mrrb/tfg/USB_Sniffer_ESP32/reference.rst

**Reference**
=============

In this files I'll anotate all the references used to develop the current project.

* *ESP32-idf template.* `ESP32-IDF-template.`_
* *ESP-IDF Docs.* `ESP-IDF Docs.`_

.. _ESP32-IDF-template.: https://github.com/espressif/esp-idf-template
.. _ESP-IDF Docs.: http://esp-idf.readthedocs.io/
