mrrb/tfg/docs/urls.md

# Lista de URLs con información relevante.

### FPGA - Verilog

1. [Tutorial de FPGA en Verilog - Juan Gonzalez-Gomez aka Obijuan](https://github.com/Obijuan/open-fpga-verilog-tutorial/wiki)

2. [ICE40 Family Datasheet - Lattice Semiconductor](http://www.latticesemi.com/view_document?document_id=49312)

3. [Project IceStorm - Clifford Wolf & Mathias Lasser](http://www.clifford.at/icestorm/)

4. [Verilog HDL Quick Reference Guide - Stuart Sutherland](http://sutherland-hdl.com/pdfs/verilog_2001_ref_guide.pdf)

5. [Lattice primitivas - Lattice Semiconductor](http://www.latticesemi.com/~/media/LatticeSemi/Documents/TechnicalBriefs/SBTICETechnologyLibrary201504.pdf)

### Protocolo USB

1. [USB made simple - MQP Electronics Ltd](http://www.usbmadesimple.co.uk/)

### Raspberry PI

1. [introducción a la programación con Raspberry Pi - Francisco Moya](https://franciscomoya.gitbooks.io/taller-de-raspberry-pi/content/es/index.html)
