mrrb/tfg/docs/proyecto/memoria/tex/simbolos.tex

\chapter*{Lista de acrónimos, siglas y símbolos}
\label{LDS}

\begin{longtable}{lcp{.8\textwidth} }

\multicolumn{3}{l}{\textbf{Acrónimos}}\\
\\
$bit$ & --- & Acrónimo inglés de \textit{binary digit} (dígito binario en español). Es la unidad más básica de información en informática, electrónica y telecomunicaciones.\\

PID & --- & Para una trama usb, acrónimo inglés de \textit{Packet ID} (identificador de paquete en español). \\

\\
\\

\multicolumn{3}{l}{\textbf{Siglas}}\\
\\
API & --- & Siglas inglesas de \textit{Application Programming Interface} (Interfaz de Programación de Aplicaciones en español).\\

CSV & --- & Siglas inglesas de \textit{Comma Separated Values} (Valores Separados por Comas en español).\\

FIFO & --- & Siglas inglesas de \textit{Firts-In Firts-Out} (Primero-en-Entrar Primero-en-Salir en español).\\

FPGA & --- & Siglas inglesas de \textit{Field-Programmable Gate Array} (Matriz de Puertas Programables en español).\\

HID & --- & Siglas inglesas de \textit{Human Interface Device} (Dispositivo de Interfaz Humana en español).\\

LED & --- & Siglas inglesas de \textit{Light Emitting Diode} (Diodo Emisor de Luz en español).\\

PC & --- & Siglas inglesas de \textit{Personal Computer} (Computadora Personal en español).\\

PCB & --- & Siglas inglesas de \textit{Printed Circuit Board} (Placa de Circuito Impreso en español).\\

RAM & --- & Siglas inglesas de \textit{Random Access Memory} (Memoria de Acceso Aleatorio en español).\\

ULPI & --- & Siglas inglesas de \textit{UTMI+ Low Pin Interface} (Interfaz UTMI+ de Bajos Pines en español).\\

USB & --- & Siglas inglesas de \textit{Universal Serial Bus} (Bus Universal en Serie en español).\\

\\
\\

\multicolumn{3}{l}{\textbf{Símbolos}}\\
\\
$B$ & --- & \emph{Byte}. Unidad de información, que por lo general agrupa 8 $bits$.\\

$Bd$ & --- & Baudio. Unidad que indica la cantidad de símbolos enviados por segundo en transmisiones digitales.\\

$Hz$ & --- & Hercio. Unidad del Sistema Internacional que indica la frecuencia de oscilación de una partícula en un periodo de un segundo.\\

$V$ & --- & Voltio. Unidad del Sistema Internacional que indica la tensión eléctrica.\\

\\
\\

\end{longtable}
