mrrb/tfg/docs/proyecto/memoria/tex/simulacion_final.tex

\chapter{Resultado de la simulación final}
\label{ch:simulacion-final}

\begin{figure}[htbp]
    \centering
    \hspace*{-1cm}
    \caption{Simulación final de botones externos (1 y 2) y lectura de registro (3)}
    \label{fig:simulacion_1_2_3}
\end{figure}

\begin{figure}[htbp]
    \centering
    \hspace*{-1.25cm}
    \caption{Simulación final de transmisión de registro (4), escritura de registro (5) y captación USB (6)}
    \label{fig:simulacion_4_5_6}
\end{figure}

\begin{figure}[htbp]
    \centering
    \hspace*{-0.9cm}
    \caption{Simulación final de envío de captura al PC (7)}
    \label{fig:simulacion_7}
\end{figure}

\begin{figure}[htbp]
    \centering
    \hspace*{-1.1cm}
    \caption{Simulación final de captación USB (8), cambio de estado del bus (9) y desactivación de envío (10)}
    \label{fig:simulacion_8_9_10}
\end{figure}
