mrrb/tfg/docs/proyecto/memoria/tex/diagramas_FPGA.tex

\chapter{Diagramas internos de la \emph{FPGA}}
\label{ch:diagramas}

%* Diagrama TOP
\begin{figure}[p]
    \centering
    
    \caption{Esquema principal usado en la \emph{FPGA}.}
    \label{fig:diagrama_fgpa_top}
\end{figure}

%* Diagrama UART_main
\begin{figure}[p]
    \centering
    
    \caption{Esquema principal del módulo de comunicación serie.}
    \label{fig:diagrama_fgpa_uart_main}
\end{figure}

%* Diagrama UART_Tx
\begin{figure}[p]
    \centering
    
    \caption{Esquema del submódulo de transmisión serie.}
    \label{fig:diagrama_fgpa_uart_tx}
\end{figure}

%* Diagrama UART_Rx
\begin{figure}[p]
    \centering
    
    \caption{Esquema del submódulo de recepción serie.}
    \label{fig:diagrama_fgpa_uart_rx}
\end{figure}

%* Diagrama ULPI_main
\begin{figure}[p]
    \centering
    
    \caption{Esquema principal del módulo de comunicación \emph{ULPI}.}
    \label{fig:diagrama_fgpa_ulpi_main}
\end{figure}

%* Diagrama ULPI_reg_rrite
\begin{figure}[p]
    \centering
    
    \caption{Esquema del submódulo de escritura de registros \emph{ULPI}.}
    \label{fig:diagrama_fgpa_ulpi_reg_write}
\end{figure}

%* Diagrama ULPI_reg_read
\begin{figure}[p]
    \centering
    
    \caption{Esquema del submódulo de lectura de registros \emph{ULPI}.}
    \label{fig:diagrama_fgpa_ulpi_reg_read}
\end{figure}

%* Diagrama ULPI_recv
\begin{figure}[p]
    \centering
    
    \caption{Esquema del submódulo de recpción de datos \emph{USB} a través de \emph{ULPI}.}
    \label{fig:diagrama_fgpa_ulpi_recv}
\end{figure}

%* Diagrama OP_buffer
\begin{figure}[p]
    \centering
    
    \caption{Esquema del módulo de almacenaje de las operaciones pendientes.}
    \label{fig:diagrama_fgpa_op}
\end{figure}
