mrrb/tfg/docs/proyecto/memoria/tex/diagramas_flujo/UART_Rx.tex

\begin{tikzpicture}[auto]
    % Config
    \tikzFlow

    % Place nodes
    \node [flowStart] (idle) {Reposo};
    
    \node [flowDecision] at ($ (idle)+(0,-2.65) $) (rxLow) {Entrada del puerto serie a nivel bajo?};
    
    \node [flowBase, below of=rxLow] (init) {Reinicio del contador de $bits$};
    
    \node [flowBase] at ($ (rxLow.east)+(3.85,1) $) (read) {Se guarda $bit$ entrante en el registro de desplazamiento};

    \node [flowDecision, below of=read] (10bitsDone) {Se han leído los $10~bits$ del mensaje?};
    
    \node [flowBase] at ($ (read)+(4.1,0) $) (increase) {Incremento del contador de $bits$};

    \node [flowBase] at ($ (10bitsDone)+(4.1,0) $) (wait) {Se espera un pulso del reloj de baudios};

    \node [flowBase, below of=10bitsDone] (save) {Se almacena el byte en memoria};

    % % Draw edges
    \path [flowLine] (idle) -- (rxLow);
    \path [flowLine] (rxLow) -- (init);
    \path [flowLine] (init.south) |- +(3.5,-1) |- (read.west);
    \path [flowLine] (read) -- (10bitsDone);
    \path [flowLine] (increase) -- (read);
    
    \node [flowHide] at ($ (idle)+(2.75,0) $) (anchor1) {};
    \path [flowLine] (rxLow) -- node [right, xshift=-1.2cm] {Sí} (init);
    \path [flowLine] (rxLow.east) node [above, xshift=0.2cm] {No} -| (anchor1.center);
    
    \path [flowLine] (save.east) -| +(4.5,0) |- (idle.east);
    
    \path [flowLine] (wait) -- (increase);
    \path [flowLine] (10bitsDone.east) node [above, xshift=0.2cm] {No} -- (wait);
    \path [flowLine] (10bitsDone) -- node [right, xshift=-1.2cm] {Sí} (save);
\end{tikzpicture}

% \begin{tikzpicture}[auto]
%     % Config
%     \tikzFlow

%     % Place nodes
%     \node [flowStart] (idle) {Reposo};
    
%     \node [flowDecision, below of=idle] (rxLow) {Entrada del puerto serie a nivel bajo?};
    
%     \node [flowBase, below of=rxLow] (init) {Reinicio del contador de $bits$};
    
%     \node [flowBase, below of=init] (read) {Se guarda $bit$ entrante en el registro de desplazamiento};

%     \node [flowDecision, below of=read] (10bitsDone) {Se han leído los $10~bits$ del mensaje?};
    
%     \node [flowBase] at ($ (read)+(4.1,0) $) (increase) {Incremento del contador de $bits$};

%     \node [flowBase] at ($ (10bitsDone)+(4.1,0) $) (wait) {Se espera un pulso del reloj de baudios};

%     \node [flowBase, below of=10bitsDone] (save) {Se almacena el byte en memoria};

%     % % Draw edges
%     \path [flowLine] (idle) -- (rxLow);
%     \path [flowLine] (rxLow) -- (init);
%     \path [flowLine] (init) -- (read);
%     \path [flowLine] (read) -- (10bitsDone);
%     \path [flowLine] (increase) -- (read);
    
%     \node [flowHide] at ($ (idle)+(3.5,0) $) (anchor1) {};
%     \path [flowLine] (rxLow) -- node [right, xshift=-1.2cm] {Sí} (init);
%     \path [flowLine] (rxLow.east) -| node [above, xshift=-1.2cm] {No} (anchor1.center);
    
%     \path [flowLine] (save.east) -| +(4.5,0) |- (idle.east);
    
%     \path [flowLine] (wait) -- (increase);
%     \path [flowLine] (10bitsDone.east) node [above, xshift=0.2cm] {No} -- (wait);
%     \path [flowLine] (10bitsDone) -- node [right, xshift=-1.2cm] {Sí} (save);
% \end{tikzpicture}
