mrrb/tfg/docs/anteproyecto/README.md

# Anteproyecto
Documento previo en el que se plantean posibles pautas y medios, así como información util y elementos de referencia a usar para el satisfacotiro desarrollo del TFG.
