mrrb/tfg/docs/files.md

# Información sobre los archivos de este directorio.

### iCE40LPHXFamilyDataSheet.pdf

Hoja de características de la familia de FPGA's ICE40 LP/HX de Lattice.

### icestick_pinout.png

Pinout del ICEstick - BQ

### SBTICETechnologyLibrary201504.pdf

Documento con primitivas para la FPGA
