mrrb/tfg/docs/proyecto/memoria/contenido.tex

%! => Hay que hacerlo, no hay nada hecho, o faltan partes
%! Revisar => Hay que terminarlo o hay que revisar que este bien redactado
%* Comprobar => Hay que asegurarse que este correctamente redactado (sobretodo en cuanto a ortografía)
%* Listo => Totalmente redactado, falta comprobación final cuando este todo el proyecto finalizado
%* Perfecto => Nada más que hacer

% Licencia
%\license{Todos los derechos reservados.}

% Símbolos (omitir si no hay gran cantidad de ellos)
\listofsymbols{simbolos.tex} %* Perfecto
\portada

\input{agradecimientos.tex} %* Perfecto
% \input{dedicatoria.tex}
\input{resumen.tex}         %* Perfecto
% \input{resumen_short.tex}

\indices

% Distribución del documento
% Documento científico-técnico (anexo TFG-08b)
\input{introduccion.tex}   %* Perfecto
\input{antecedentes.tex}   %* Perfecto
\input{objetivos.tex}      %* Perfecto
\input{contribuciones.tex} %* Perfecto
\input{procedimiento.tex}  %* Perfecto
\input{resultados_hw.tex}  %* Perfecto
\input{resultados_sw.tex}  %* Perfecto
\input{conclusiones.tex}   %* Perfecto
