mrrb/tfg/docs/proyecto/memoria/datos-tfg.tex

% Datos del TFG
\title{Analizador USB}
\author{Mario Rubio Asensio}
\email{mario.rubio2@alu.uclm.es}
\director{Francisco Moya Fernández}
\tfgid{19-B-225530}
\gitrepo{https://github.com/mario-mra/tfg}

% Opcionales
% \homepage{https://github.com/FranciscoMoya/eii-tfg}
% \address{UCLM --- Escuela de Ingeniería Industrial\\
% Campus Universitario de la Real Fábrica de Armas}
% \zipcode{45071}
% \phone{925 268 800 x.3729}
