mrrb/tfg/docs/proyecto/memoria/tex/agradecimientos.tex

\begin{agradecimientos}

    \itshape

    En primer lugar, quisiera agradecer al director del presente Trabajo Fin de Grado, D. Francisco Moya Fernández, por brindarme la oportunidad de realizar este proyecto  y por la ayuda ofrecida.
    
    A mis padres y hermana, que siempre han estado y estarán para apoyarme en todo momento.

    A mis compañeros de la carrera, con los que tantos momentos he compartido.

    A mis amigos, tanto de León como de Toledo, que nunca fallan.

    A todos ellos, muchas gracias.
 
\end{agradecimientos}
