mrrb/tfg/docs/proyecto/memoria/tex/introduccion.tex

\chapter{Introducción} 
\label{ch:introduccion}

%* Listo
Durante estas dos ultimas décadas, el bus USB\cite{craigpeacock2010} (\emph{Universal Serial Bus}) se ha impuesto como uno de los grandes pilares de la comunicación en la informática moderna, no solo en productos de grandes masas (como dispositivos de almacenamiento o periféricos HID\cite{usb:hid}), sino también en sectores más complejos y robustos como lo son el militar o el industrial.

%* Listo
Al ser un bus tan ampliamente utilizado, existen multitud de ocasiones en las que sería de gran utilidad poder disponer de los datos que circulan por él, ya sea para fines de seguridad\cite{NISSIM2017675}, control, ingeniería inversa o búsqueda y solución de problemas. Por ello, es de gran interés disponer de sistemas capaces de realizar dicha tarea de forma económica y sencilla.

%* Listo
Se considera entonces la elaboración del presente proyecto, en el que se plantea un sistema de \textbf{captación de tramas USB por \textit{hardware}} que sea capaz como mínimo de obtener señales tanto \textit{Low Speed} ($1.5~Mbit/s$) como \textit{Full Speed} ($12~Mbit/s$), todo ello a un coste bajo que pueda suplir la demanda existente, y utilizando en gran medida herramientas y utilidades de código libre.

%* Listo
\section{Organización de la memoria} 
La organización de este documento es conforme al anexo TFG-08b\cite{tfg08b} de la Normativa Trabajo Fin de Grado de la Escuela de Ingeniería Industrial de Toledo, de la Universidad de Castilla-La Mancha, aprobada en Junta de Escuela el 23 de junio de 2016. Se descompone en los siguientes capítulos.

%* Listo
\begin{description}
    %* Listo
    \item[Capítulo~\ref{ch:introduccion}]
    Presente capítulo. Se introduce el problema a tratar.
    
    %* Listo
    \item[Capítulo~\ref{ch:antecedentes}]
    Analiza los antecedentes y el estado del arte de los dispositivos de captura USB.
    
    %* Listo
    \item[Capítulo~\ref{ch:objetivos}]
    Enumera y justifica los objetivos del proyecto.
    
    %* Listo
    \item[Capítulo~\ref{ch:contribuciones}]
    Enumera las principales contribuciones y aportaciones en este TFG.
    
    %* Listo
    \item[Capítulo~\ref{ch:procedimiento}]
    Describe las directivas de desarrollo empleadas durante la ejecución del TFG.
    
    %* Listo
    \item[Capítulo~\ref{ch:resultados_hw}]
    Describe en detalle las pruebas realizadas y los resultados obtenidos de los elementos \emph{hardware} del sistema.
    
    %* Listo
    \item[Capítulo~\ref{ch:resultados_sw}]
    Describe en detalle los resultados obtenidos de los elementos \emph{software} del sistema.
    
    %* Listo
    \item[Capítulo~\ref{ch:conclusiones}]
    Recopila las principales conclusiones del proyecto y posibles trabajos futuros.
    
    %* Listo
    \item[Anexo~\ref{ch:diagramas}]
    Muestra gráficamente las relaciones entre los módulos diseñados.
    
    %* Listo
    \item[Anexo~\ref{ch:maquinas-estados}]
    Muestra los esquemas de las maquinas de estados internas de los módulos diseñados.
    
    %* Listo
    \item[Anexo~\ref{ch:simulacion-final}]
    Muestra el resultado de la simulación final del sistema.
    
    %* Listo
    \item[Anexo~\ref{ch:manual}]
    Detalla los procedimientos a seguir para la instalación y utilización del sistema.
\end{description}

%* Listo
\section{Repositorio de información}
Todo el material generado durante la ejecución de este proyecto está disponible tanto en el disco adjunto, como en \thegitrepo{}. Se incluye el código \LaTeX{} del presente documento, el código fuente de los programas y módulos realizados, y todos los datos generados en la evaluación de resultados.

% \chapter{Introducción} 
% \label{ch:introduccion-plantilla}

% En este capítulo debes introducir el problema sin divagar, sin copiar de otros documentos y sin utilizar un lenguaje excesivamente técnico.  Tampoco utilices un lenguaje informal.  Este capítulo debería convencer al cliente de que el proyecto merece la pena.  Es decir, es un problema real y no está resuelto completamente.

% Redacta la introducción al final del TFG, cuando tengas elaborado el capítulo de antecedentes, los resultados y su discusión.  De esta forma podrás evitar repetir argumentos que ya están en esos capítulos.  La introducción debe introducir también el contexto en el que se desarrolla el TFG.

% Utiliza secciones y subsecciones para organizar el contenido del capítulo.  Utiliza preferentemente frases cortas.

% Por cierto, el cliente es el que paga.  En el TFG el que paga es el tribunal y tu director o directores.  Así que a quien tienes que convencer es a ellos.  El tribunal no lo conocerás a priori.  Por eso la memoria debe estar escrita para que la entienda alguien que no es especialista en el campo de aplicación.  Pero eso no implica que se toleren la falta de rigor o la falta de argumentación técnica.  Solo implica que los argumentos específicos hay que explicarlos o citar la fuente que los explica.

% \section{Organización de la memoria} 
% \label{sec:organizacion-memoria}

% La organización de este documento es conforme al anexo TFG-08b~\cite{tfg08b} de la Normativa Trabajo Fin de Grado de la Escuela de Ingeniería Industrial de Toledo, de la Universidad de Castilla-La Mancha, aprobada en Junta de Escuela el 23 de junio de 2016. Se descompone en los siguientes capítulos.

% \begin{description}
%     \item[Capítulo~\ref{ch:antecedentes}] Analiza los antecedentes y estado del arte en relación al tema del proyecto.
%     \item[Capítulo~\ref{ch:objetivos}] Enumera y justifica los objetivos del proyecto y establece los límites intrínsecos y extrínsecos de ejecución del TFG.
%     \item[Capítulo~\ref{ch:contribuciones}] Enumera las principales contribuciones y aportaciones personales del autor en este TFG.
%     \item[Capítulo~\ref{ch:procedimiento}] Describe la metodología de desarrollo empleada durante la ejecución del TFG.
%     \item[Capítulo~\ref{ch:resultados}] Describe en detalle las pruebas realizadas y los resultados obtenidos.
%     \item[Capítulo~\ref{ch:discusion-resultados}] Discute los resultados en relación a los objetivos del proyecto.
%     \item[Capítulo~\ref{ch:conclusiones}] Recopila las principales conclusiones del proyecto.
%     \item[Anexos] Complementan la información del cuerpo del documento con información técnica útil para reproducir los resultados, pero innecesaria para comprender en su totalidad el TFG realizado.
% \end{description}

% \warning{Al finalizar el resto de los capítulos revisa esta descripción del documento para que coincida con lo que realmente contiene la memoria.  Por ejemplo, es frecuente fusionar varios capítulos en uno cuando son muy pequeños.  También es frecuente lo contrario, dividir un capítulo en varios cuando es muy extenso.}

% \section{Repositorio de información}
% \label{sec:repositorio}

% Todo el material generado durante la ejecución de este proyecto está disponible en \thegitrepo{}.  El repositorio incluye el código \LaTeX{} del presente documento, el código fuente de los programas realizados o modificados, y todos los datos generados en la evaluación de resultados.
