mrrb/tfg/ICEstick/USB3300_sniffer/modules/SPI_COMM/SPI-paper.pdf

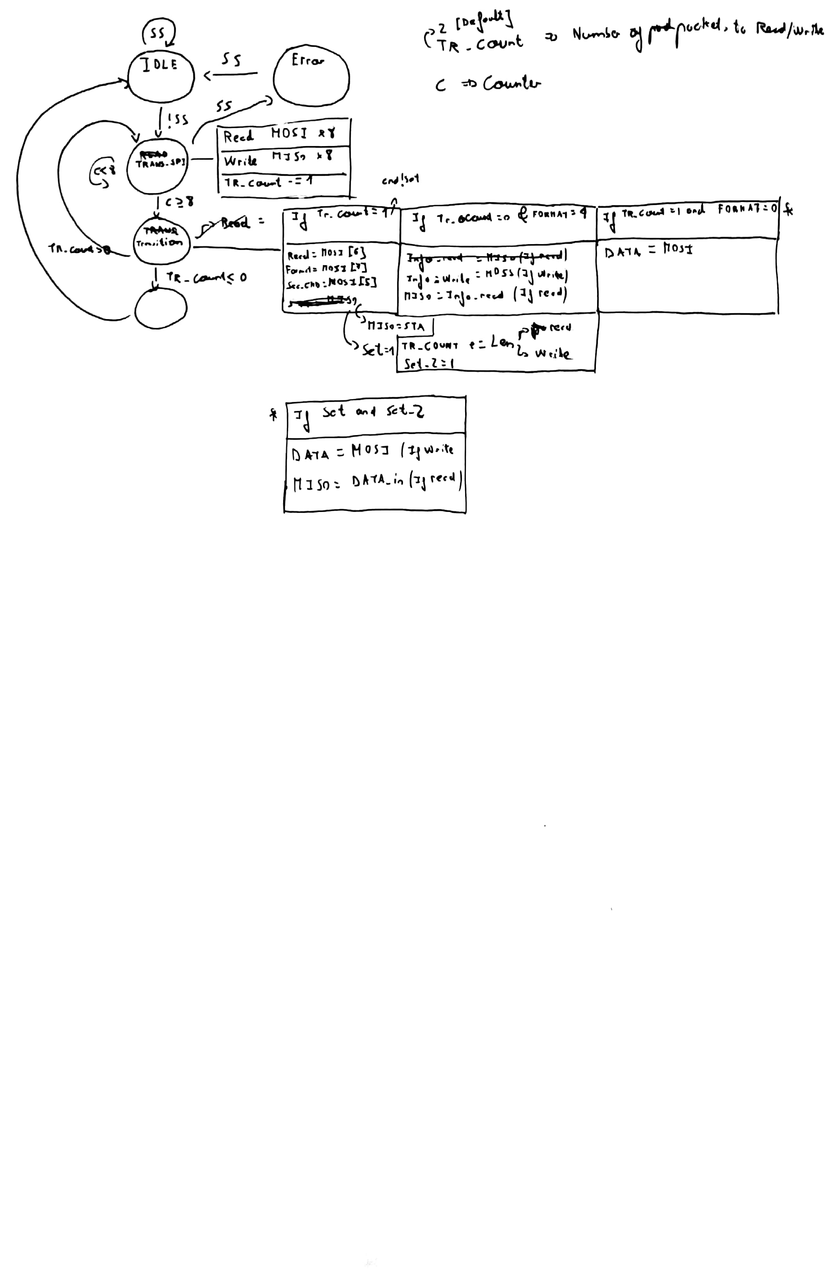
[picture p11: page 1]

Scanned by CamScanner

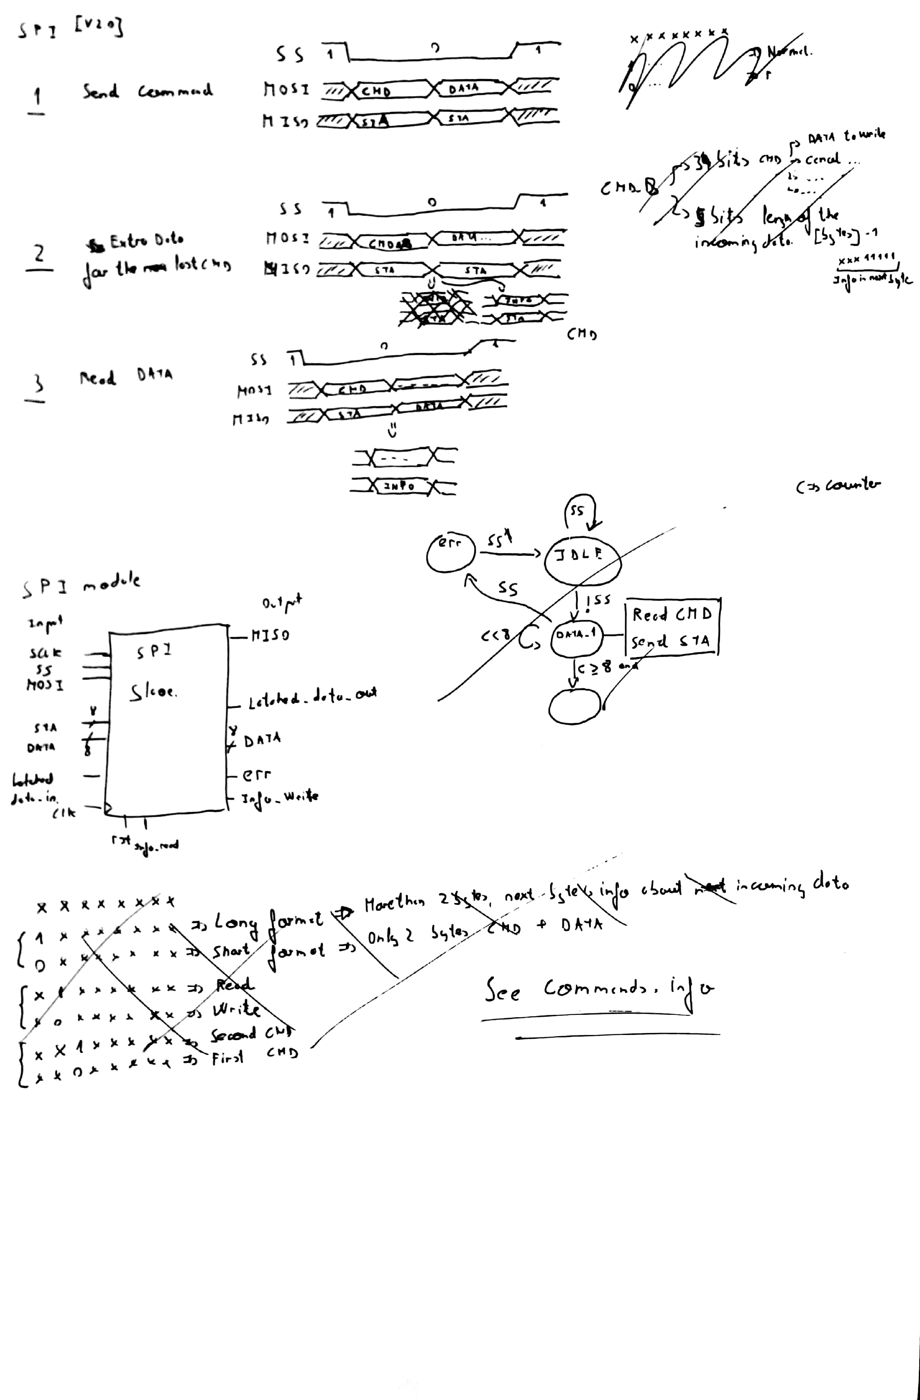
[picture p12: page 2]

Scanned by CamScanner
