mrrb/tfg/docs/proyecto/memoria/fig/esquemas/debounce-eps-converted-to.pdf

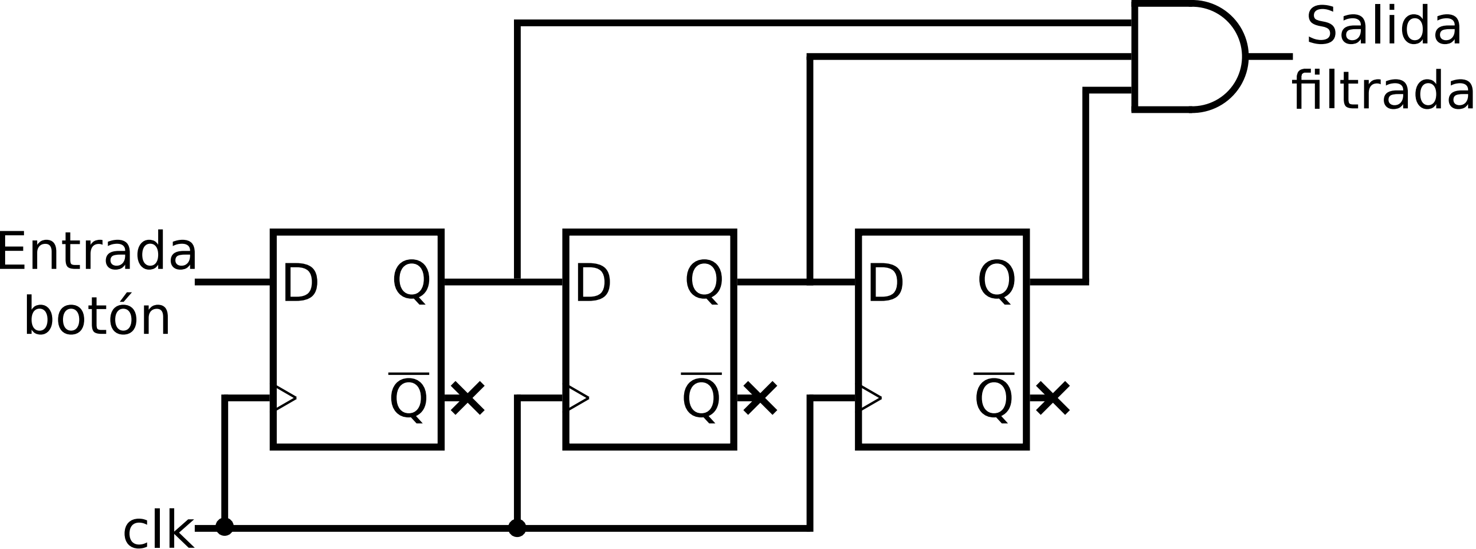
[picture p15: figure]
Salida ltrada; Entrada botón; clk
