mrrb/tfg/docs/proyecto/memoria/fig/esquemas/divisor_flipflop_D-eps-converted-to.pdf

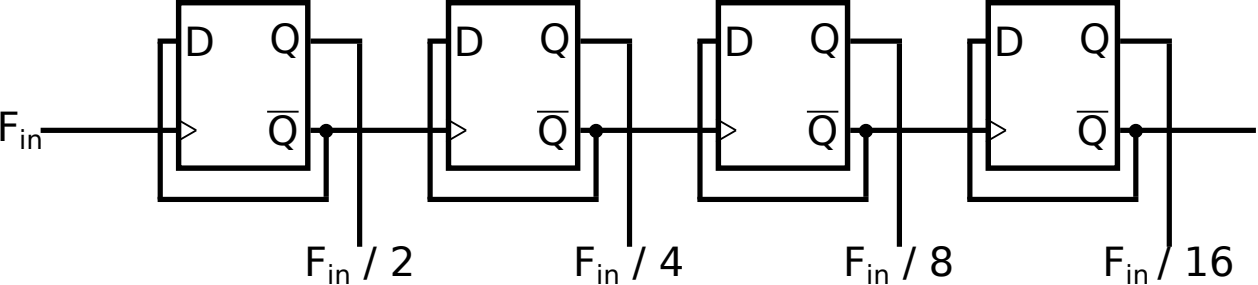
[picture p16: figure]
Fin / 2; Fin / 4; Fin / 8; Fin / 16; Fin
