mrrb/tfg/docs/proyecto/memoria/fig/esquemas/serie-eps-converted-to.pdf

# START B0B1B2B3B4B5B6B7 END

1

0

## Reloj

Bit de inicio (0) | Datos | Bit de parada (1)
