mrrb/tfg/docs/proyecto/memoria/fig/esquemas/FIFO-eps-converted-to.pdf

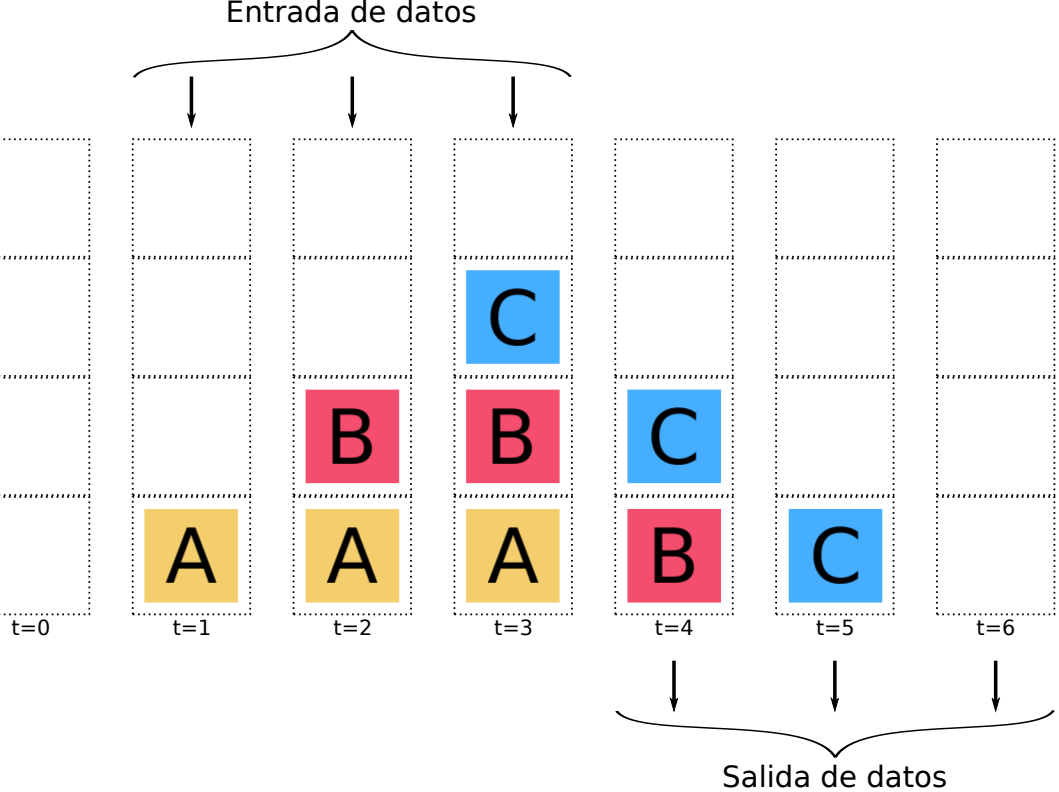
[picture p17: figure]
Entrada de datos; Salida de datos
