mrrb/tfg/docs/proyecto/memoria/tex/old/simbolos.tex

\chapter*{Lista de símbolos, abreviaciones y siglas}\label{LDS}

\begin{longtable}{lcp{.8\textwidth} }
\multicolumn{3}{l}{\textbf{Siglas}}\\
\\
PCB & --- & Siglas inglesas de \textit{Printed Circuit Board} (Placa de Circuito Impreso en español).\\
$V$ & --- & Volumen (m$^3$).\\
\\
\\
\multicolumn{3}{l}{\textbf{Minúsculas}}\\
\\
$c$ & --- & Velocidad de la luz en el vacío (m/s). La velocidad de la radiación electromagnética es independiente de la velocidad del emisor.\\
$i$ & --- & Raíz de menos uno (-).\\
\\
\\
\multicolumn{3}{l}{\textbf{Letras griegas}}\\
\\
$\alpha$ & --- & El principio de todo (-).\\
$\pi$ & --- & Pastel en inglés (-).\\
\end{longtable}

% Bauds
% bits
% Kbits
% HUB
% API
