mrrb/tfg/docs/proyecto/memoria/tex/old/agradecimientos.tex

\begin{agradecimientos}

%!
En primer lugar, quisiera agradecer al director del presente Trabajo Fin de Grado, Francisco Moya Fernández, ...

%!
También quisiera agradecer a todos lod profesores de la Escuela de Ingeniería Industrial de Toledo, ...

%!
A mis compañeros de carrera ...

%!
A mis amigos que ...

%!
A mis padres y hermana, que siempre han estado y estarán para apoyarme en todo momento ...

%? muletilla
que tanto me han soportado 

\end{agradecimientos}
