mrrb/tfg/docs/proyecto/memoria/tex/old/resumen.tex

\begin{resumen}
Aquí va el resumen en español. Entre 1000 y 1500 palabras (ver Anexo TFG-08). 

\warning{Escribe el resumen en estilo periodístico, desde lo más general a lo más específico.  Desde lo más importante a lo menos importante.  Esto último será especialmente útil cuando tengas que rellenar los \emph{Datos del TFG} en Campus Virtual. En el formulario solo te permiten añadir un máximo de 600 palabras.  Si el resumen está en formato periodístico bastará con seleccionar los primeros párrafos.}
\end{resumen}

\begin{abstract}
Write here the abstract in english. It must be between 1000 and 1500 words long (see Anexo TFG-08).
\end{abstract}
