mrrb/tfg/docs/proyecto/memoria/fig/capturas_terminal/utilidad_divisiones_reloj_raw.png

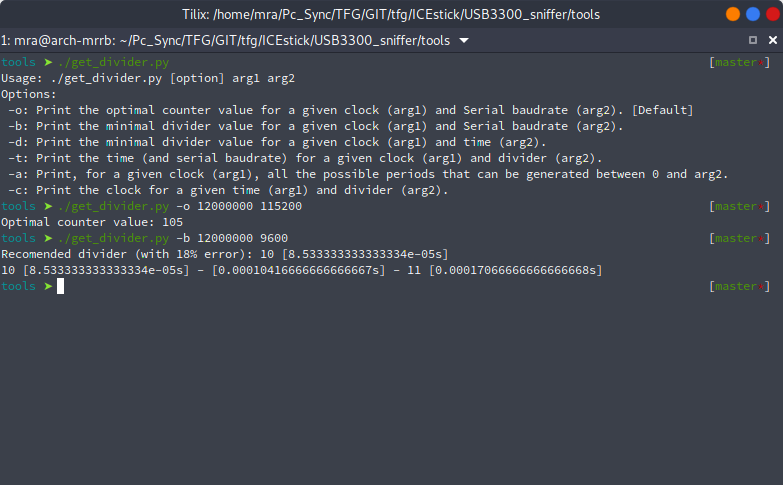
docs/proyecto/memoria/fig/capturas_terminal/utilidad_divisiones_reloj_raw.png
