mrrb/tfg/docs/proyecto/memoria/fig/diagramas_FPGA/diagramas_funcionamiento/diagramas_funcionamiento.png

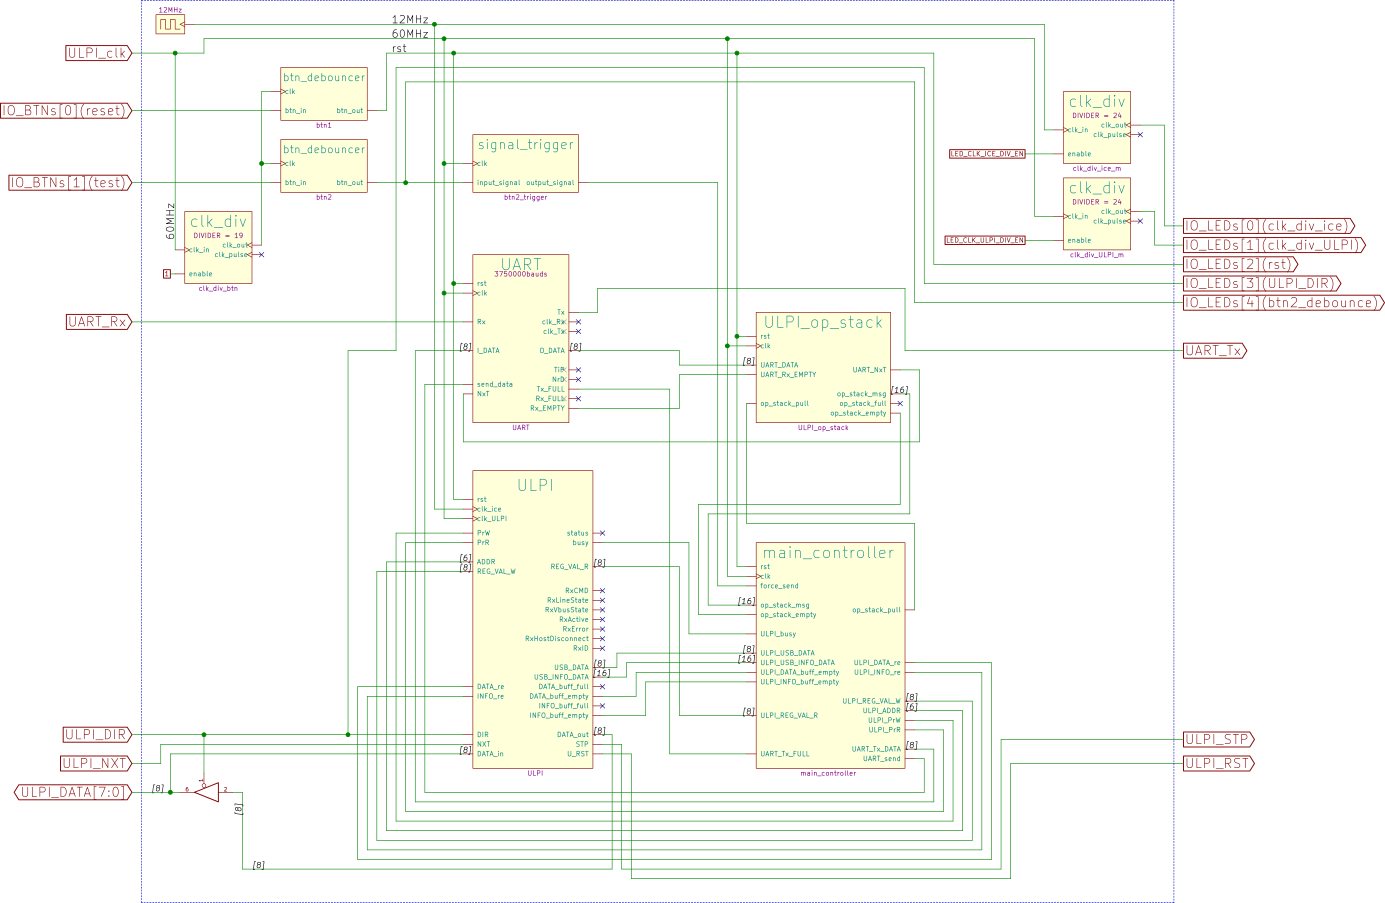
docs/proyecto/memoria/fig/diagramas_FPGA/diagramas_funcionamiento/diagramas_funcionamiento.png
