mrrb/tfg/docs/proyecto/memoria/fig/menu_app/escritura.png

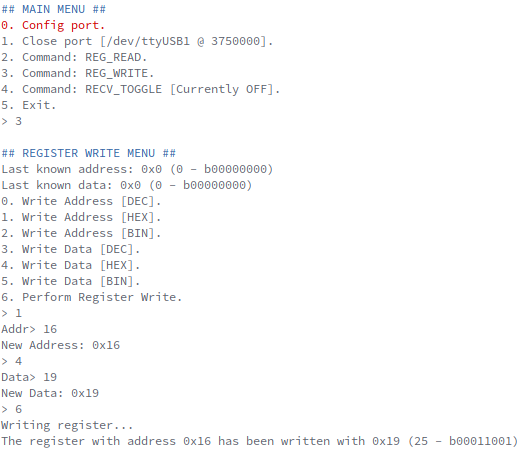
docs/proyecto/memoria/fig/menu_app/escritura.png
