mrrb/tfg/docs/proyecto/memoria/fig/menu_app/lectura.png

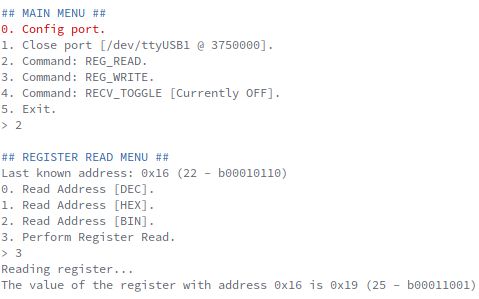
docs/proyecto/memoria/fig/menu_app/lectura.png
