mrrb/tfg/docs/proyecto/memoria/sty/uclm_to.jpg

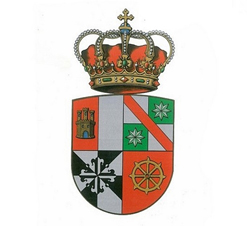
docs/proyecto/memoria/sty/uclm_to.jpg
