mrrb/tfg/docs/referencia/ESP32/ESP-32-Dev-Board-Pinout.jpg

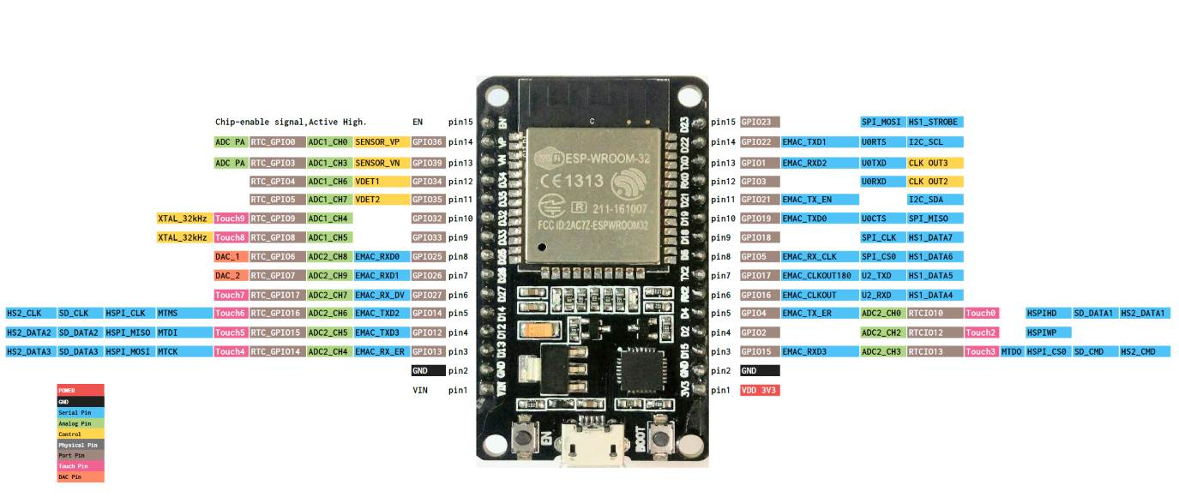
docs/referencia/ESP32/ESP-32-Dev-Board-Pinout.jpg
