mrrb/tfg/3D_base/P1_V1.stl

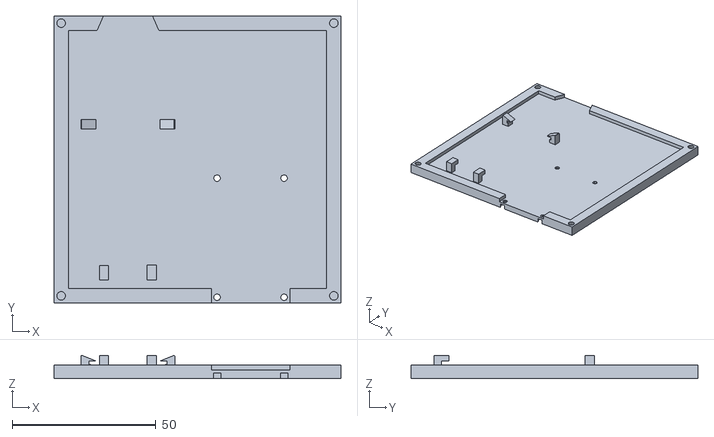
[picture p26: CAD file, 2018-11-26]
3D_base/P1_V1.stl
100.0 x 100.0 x 8.10
