mrrb/tfg/3D_base/test.stl

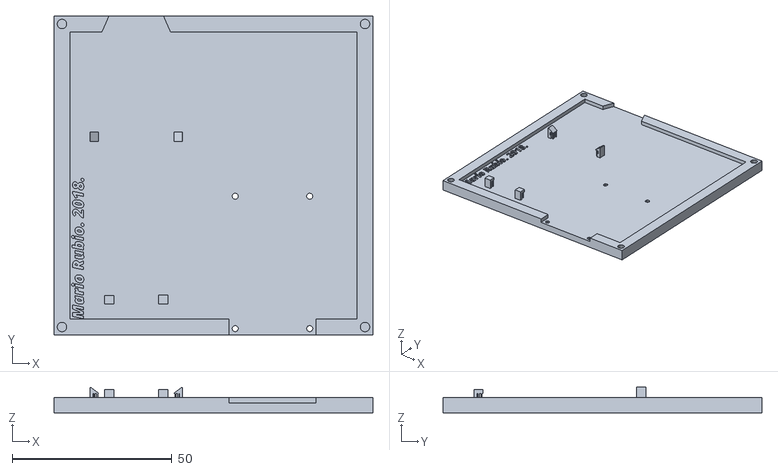
[picture p27: CAD file, 2018-11-26]
3D_base/test.stl
100.0 x 100.0 x 8.00
