mrrb/tfg/ICEstick/test/SPI_test/Readme.md

# Code obtain from

[julian1 - ice40-spi-usb-controller](https://github.com/julian1/ice40-spi-usb-controller)
