mrrb/tfg/docs/proyecto/memoria/tex/resultados_sw.tex

\chapter{Resultados \emph{software}}
\label{ch:resultados_sw}

%* Listo
Aun teniendo más importancia la parte \emph{hardware} comentada en el capítulo~\ref{ch:resultados_hw}, el sistema no sería funcional sin el \emph{software}, que utilizando los recursos creados, pueda recibir y almacenar la captura. Además, se han creado varias utilidades que han sido ayuda en las fases de diseño \emph{hardware}.

%* Listo
\section{Aplicaciones de apoyo}
A medida que se ha ido desarrollando la parte \emph{hardware}, se han creado varias utilidades en lenguaje \emph{Python}, con las que realizar cálculos de forma rápida o con las que comprobar el funcionamiento de ciertas partes del sistema. Dichas aplicaciones se encuentran en el directorio \emph{.\textbackslash ICEstick\textbackslash USB3300\_sniffer\textbackslash tools\textbackslash} del repositorio.

Hay que destacar las siguientes:
\begin{enumerate}
    %* Listo
    \item \textbf{Utilidad de divisiones del reloj (\emph{get\_divider.py}).} \\
    Utilidad con la que poder realizar de forma rápida varios cálculos relacionados con los relojes de entrada. Por ejemplo, obtener los valores óptimos con los que dividir un reloj para generar unos baudios deseados. En el listado \ref{src:utilidad_divisiones_reloj_out} se plasma un ejemplo de uso.
    \begin{lstlisting}[
        caption={Ejemplo de la utilidad de divisiones de reloj.},
        label=src:utilidad_divisiones_reloj_out]
$ ./get_divider.py
  Usage: ./get_divider.py [option] arg1 arg2
  Options: 
      -o: Print the optimal counter value for a given clock (arg1) and Serial baudrate (arg2). [Default]
      -b: Print the minimal divider value for a given clock (arg1) and Serial baudrate (arg2).
      -d: Print the minimal divider value for a given clock (arg1) and time (arg2).
      -t: Print the time (and serial baudrate) for a given clock (arg1) and divider (arg2).
      -a: Print, for a given clock (arg1), all the possible periods that can be generated between 0 and arg2.
      -c: Print the clock for a given time (arg1) and divider (arg2).
$ ./get_divider.py -o 12000000 115200
  Optimal counter value: 105
$ ./get_divider.py -b 12000000 9600
  Recomended divider (with 18% error): 10 [8.533333333333334e-05s]
  10 [8.533333333333334e-05s] - [0.00010416666666666667s] - 11 [0.00017066666666666668s]          
    \end{lstlisting}
    
    %* Listo
    \item \textbf{Utilidad de generación de baudios (\emph{gen\_bauds.py}).} \\
    Pequeña aplicación que, para los $baudios$ más comunes, genere varias definiciones en lenguaje \emph{Verilog} a usar por el módulo encargado de generar el reloj de baudios. En el listado \ref{src:utilidad_baudios_out} se muestra un ejemplo de la salida de la aplicación ante un reloj de $60MHz$.
%     \\ \noWord[Borrar listado??? La verdad, es algo inutil ponerlo]
    \begin{lstlisting}[
        caption={Ejemplo de la utilidad de generación de baudios ante \emph{60MHz} de entrada.},
        label=src:utilidad_baudios_out]
$ ./gen_bauds.py
  `define B921600 66
  `define B460800 131
  `define B256000 235
  `define B230400 261
  `define B153600 391
  `define B128000 469
  `define B115200 521
  `define B57600  1042
  `define B56000  1072
  `define B38400  1563
  `define B28800  2084
  `define B19200  3125
  `define B14400  4167
  `define B9600   6250
  `define B4800   12500
  `define B2400   25000
  `define B1200   50000
  `define B600    100000
  `define B300    200000
  `define B110    545455
    \end{lstlisting}
    
    %* Listo
    \item \textbf{Utilidad de control serie (\emph{serial\_control.py}).} \\
    Aplicación, que usando una librería encargada de controlar puertos serie, realiza varias comprobaciones del protocolo creado. Esta se puede configurar para abrir el puerto serie a cualquier velocidad, y poder enviar comandos de prueba.
\end{enumerate}

%* Comprobar
\section{Información de la aplicación}
Tal como se ha comentado al principio de este capítulo, aun teniendo mayor carga la parte \emph{hardware}, es esencial implementar una aplicación que se comunique con la FPGA y permita su funcionamiento. Esta aplicación se encuentra en el directorio \emph{.\textbackslash PC\textbackslash app\textbackslash} del repositorio.

Para ello, utilizando el lenguaje C, se ha creado una aplicación que dando varias opciones de control con una simple interfaz, es capaz de enviar comandos o recibir datos USB, y a su vez, es capaz de almacenarlos para su posterior estudio. A grandes rasgos, en la figura~\ref{fig:flujo_app} se muestra un esquema de funcionamiento de la aplicación.

Esta aplicación se ha dividido de la siguiente manera:
\begin{enumerate}
    %* Listo
    \item \textbf{Hilo encargado de controlar las entradas de usuario.} \\
    Tanto la configuración a usar para conectarse a la \emph{FPGA} (puerto serie y su velocidad), como los comandos a enviar, son introducidos al programa por medio de un simple menú basado en texto desde la terminal. Este permite:
    \begin{enumerate}
        \item[Opción 0.] Configurar el puerto serie (puerto a usar y velocidad en baudios).
        \item[Opción 1.] Abrir/cerrar el puerto serie seleccionado.
        \item[Opción 2.] Realizar una operación de lectura de registro.
        \item[Opción 3.] Realizar una operación de escritura de registro.
        \item[Opción 4.] Activar/desactivar el envío de datos USB al PC.
        \item[Opción 5.] Cerrar programa y guardar captura.
    \end{enumerate}

    En la figura~\ref{fig:matriz-app-menu} se muestra dicho menú, y a su vez, se ejemplifica un proceso de escritura y posterior lectura del registro con dirección \emph{0x16} (registro que según la hoja de características del integrado \emph{USB3300}\cite{microchip:usb3300} es de libre utilización).

    \begin{figure}[htbp]
        \centering
        \subfigure[Operación de escritura]{
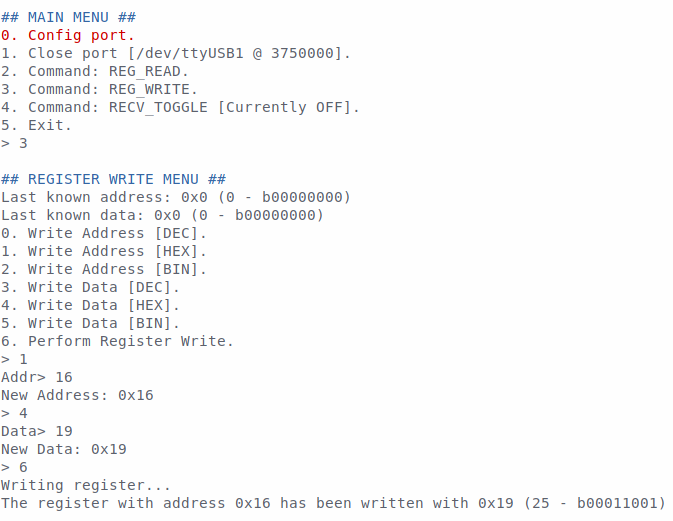
[picture p37: docs/proyecto/memoria/fig/menu_app/escrituraB.png]
            
            \label{fig:matriz-app-menu:escritura}
        }
        \subfigure[Operación de lectura]{
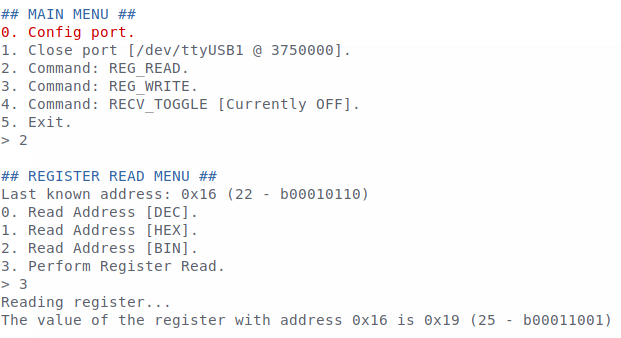
[picture p38: docs/proyecto/memoria/fig/menu_app/lecturaB.png]
            
            \label{fig:matriz-app-menu:lectura}
        } \\
        \caption{Ejemplo de escritura de registro y su posterior lectura usando el menú de la aplicación} 
        \label{fig:matriz-app-menu}
    \end{figure}
    
    %* Listo
    \item \textbf{Hilo encargado de gestionar la comunicación con la \emph{FPGA}, así como almacenar la trama capturada.} \\
    Haciendo uso de la librería \emph{libserialport}\footnote{Librería compatible con sistemas operativos Linux, Mac OS X, FreeBSD, Windows y Android. Página web de referencia: \url{https://sigrok.org/wiki/Libserialport}}, se establece una comunicación serie entre la FPGA por la que enviar las solicitudes de comandos, y recibir los datos de captura. Al finalizar el proceso de recepción de datos, es este hilo también el encargado de guardar la captura en un archivo para su posterior análisis.

    \begin{figure}[hbtp]
        \centering
        \scalebox{0.8} {\input{diagramas_flujo/app.tex}}
        \caption{Diagrama de funcionamiento de la aplicación}
        \label{fig:flujo_app}
    \end{figure}
    
\end{enumerate}

%* Listo
\section{Información del archivo generado}
Se ha elegido almacenar la información capturada en un archivo formato \emph{JSON}\footnote{Formato de texto, que permite almacenar información de forma estructurada.}. Para cada paquete capturado se almacena el último estado del bus conocido (\emph{TxCMD}), la longitud de paquetes capturados y los propios datos. En la figura~\ref{fig:tree-json} se muestra la estructura utilizada en el archivo.

\begin{figure}[!hbtp]
    \centering
    \begin{minipage}{6cm}
        \dirtree{%
            .1 dump.json.
            .2 date.
            .2 USB\_data.
            .3 captura[0].
            .4 TxCMD.
            .4 DataLen.
            .4 data.
            .5 data[0].
            .5 \ldots.
            .5 data[DataLen-1].
            .3 \ldots.
            .3 captura[n].
        }
    \end{minipage}
    \caption{Estructura del archivo \emph{JSON} donde se almacena la captura}
    \label{fig:tree-json}
\end{figure}

Para poder analizar la captura en la aplicación de análisis \emph{Wireshark}, se ha creado otra utilidad (situada en el directorio \emph{.\textbackslash PC\textbackslash json2pcap\textbackslash} del repositorio), que a partir del archivo \emph{JSON} generado anteriormente, lo transforme a \emph{PCAP}. Esta transformación no sigue la estructura de ningún disector\cite{wiresharkdisector2014} actual, por lo que en \emph{Wireshark} solo se consigue visualizar los datos de una forma más estructura sin dar información adicional.

% \chapter{Resultados}
% \label{ch:resultados-plantilla}

% Escribe en este capítulo los resultados del proyecto.  Este capítulo debería explicar los resultados de forma global, no los resultados de cada iteración.  Probablemente será el capítulo con más tablas y gráficas.  Revisa las secciones~\ref{sec:figuras} y~\ref{sec:tablas} para aprender cómo se escriben en \LaTeX{}.
