mrrb/tfg/docs/proyecto/memoria/tex/discusion-resultados.tex

\chapter{Discusión de resultados}
\label{ch:discusion-resultados}

La discusión de resultados se presenta de forma separada a los resultados propiamente dichos, porque de esta forma los resultados son directamente aprovechables en cualquier trabajo derivado.  Pero si el capítulo queda demasiado pequeño no dudes en mezclarlo con el anterior en un único capítulo de \emph{Resultados y discusión} o con el siguiente en un capítulo de \emph{Discusión de resultados y conclusiones}.

% \chapter{Discusión de resultados}
% \label{ch:discusion-resultados-plantilla}

% La discusión de resultados se presenta de forma separada a los resultados propiamente dichos, porque de esta forma los resultados son directamente aprovechables en cualquier trabajo derivado.  Pero si el capítulo queda demasiado pequeño no dudes en mezclarlo con el anterior en un único capítulo de \emph{Resultados y discusión} o con el siguiente en un capítulo de \emph{Discusión de resultados y conclusiones}.
