mrrb/tfg/TODO.md

# ToDo

## FPGA

* Crear máquina de estados principal (de forma básica, para ir actulizandola poco a pop) en el modulo top.v.
* Limpiar codigo I.
* Comentar todos los modulos ya creados I.

___

## PC (Equipo de analisis)

* Modulo que lea/escriba en el bus SPI de la FPGA con maestro.

___

## Memoria

* ~~Decidir si utilizar LaTeX o Libreoffice.~~ _LaTeX [01/10/2018]_
* Creación de las partes de la memoria.

___

## KiCAD

* Mirar como hacer la placa.
* Mirar que componentes poner.

___

## Otras cosas

* Redactar una mejor descripción del del TFG en el archivo README principal.
* ~~test~~ _[27/03/2018]_
