mrrb/tfg/docs/proyecto/memoria/fig/otro/ej_simulacion_gtkwave-eps-converted-to.pdf

# Time

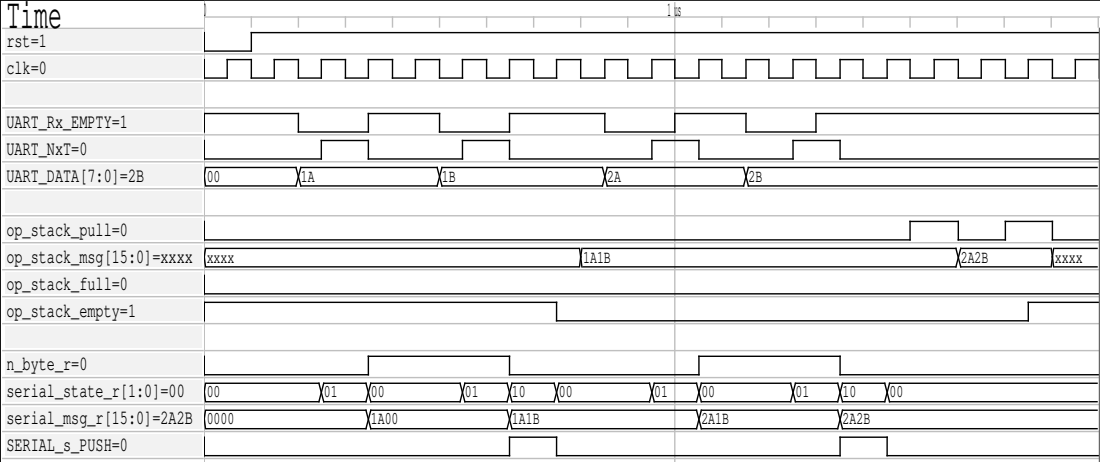
[picture p44: page 1]
xxxx; rst=1; clk=0; UART_Rx_EMPTY=1; UART_NxT=0; UART_DATA[7:0]=2B; op_stack_pull=0; op_stack_msg[15:0]=xxxx; op_stack_full=0; op_stack_empty=1; n_byte_r=0; serial_state_r[1:0]=00; serial_msg_r[15:0]=2A2B; SERIAL_s_PUSH=0
