mrrb/tfg/docs/proyecto/memoria/fig/esquemas/esquema-captura-hardware-2-eps-converted-to.pdf

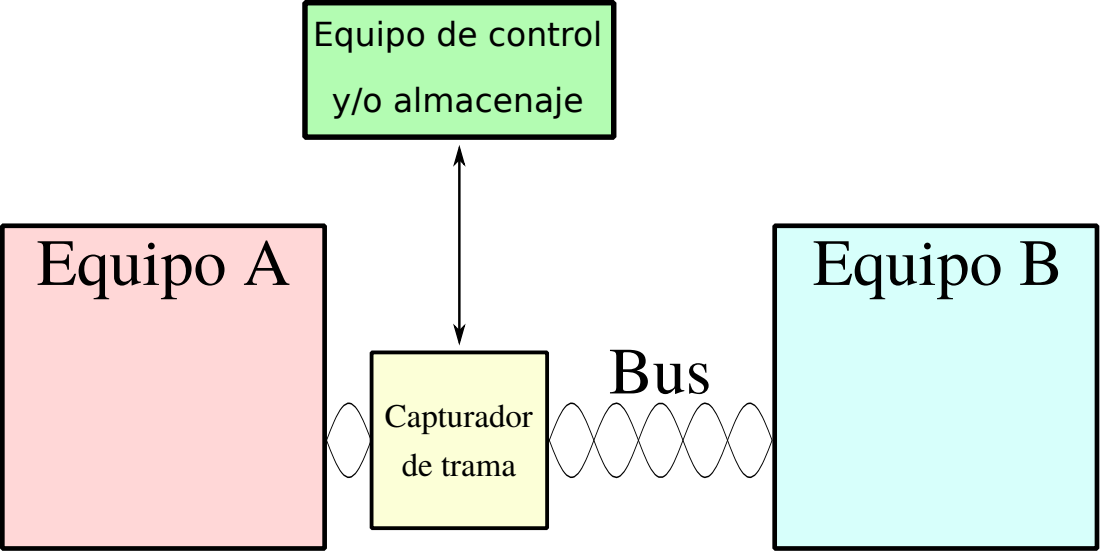
[picture p45: page 1]
Equipo A; Equipo B; Capturador; de trama; Bus; y/o almacenaje

Equipo de control
