mrrb/tfg/docs/proyecto/memoria/fig/esquemas/esquema-captura-hardware-eps-converted-to.pdf

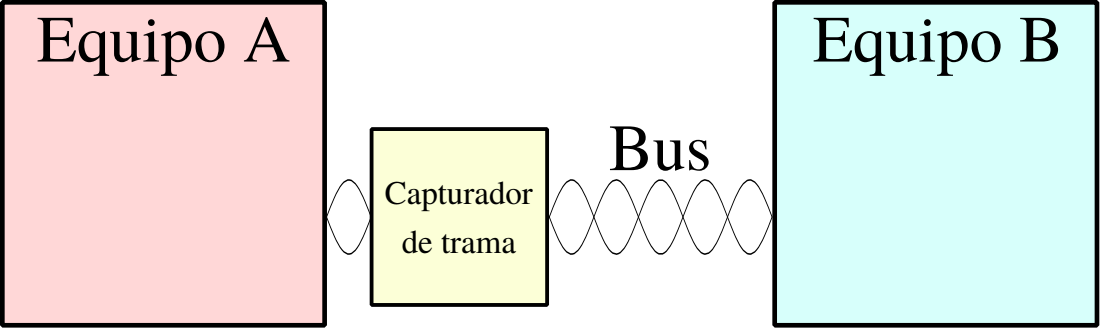
[picture p46: page 1]
Equipo A; Equipo B; Capturador; de trama; Bus
