mrrb/tfg/docs/proyecto/memoria/fig/diagramas_FPGA/top-eps-converted-to.pdf

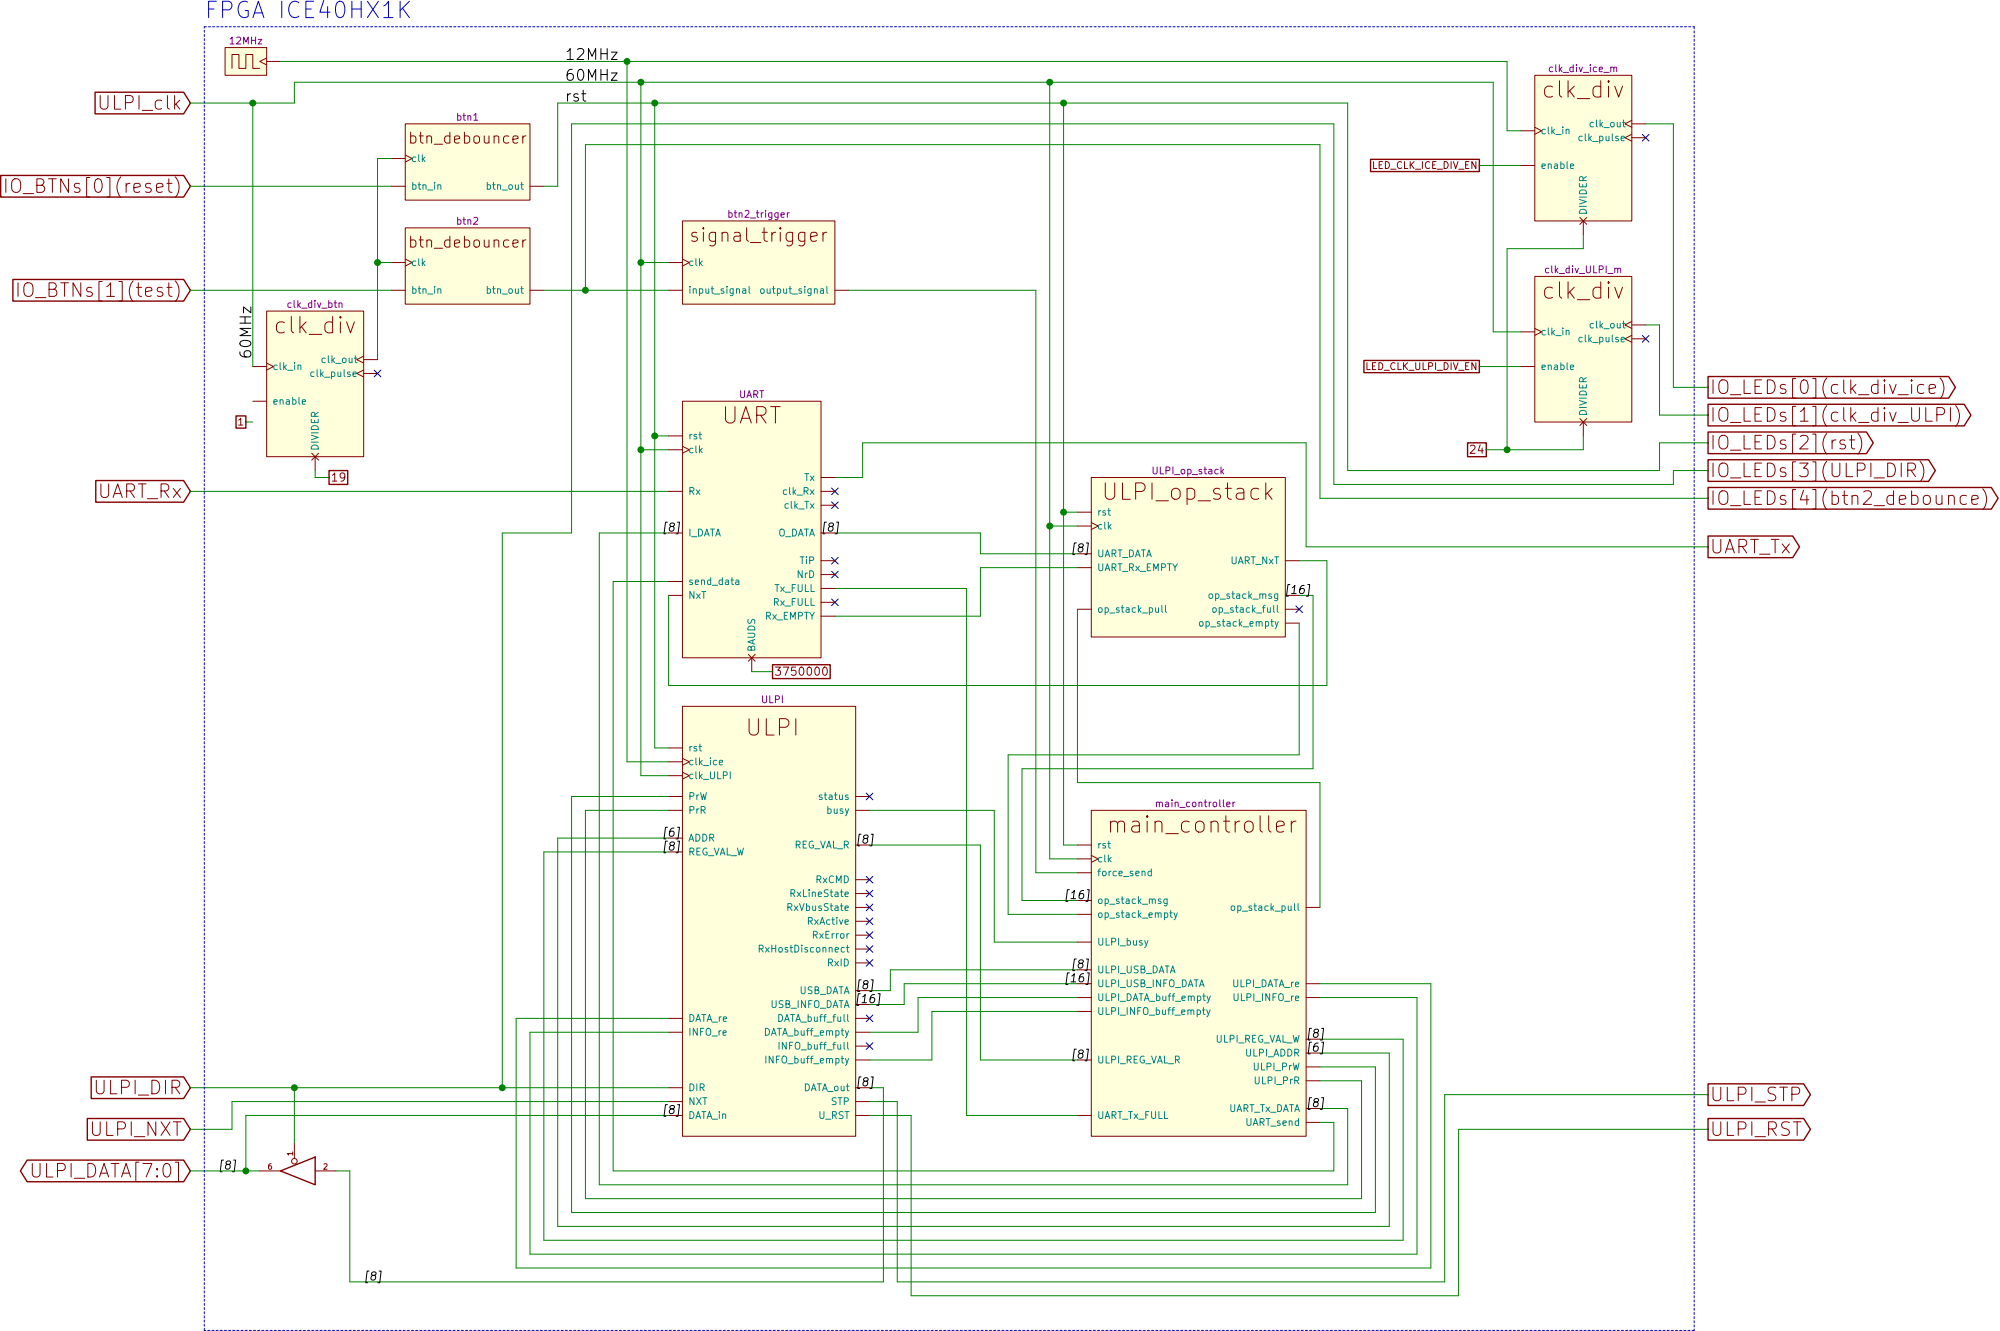
[picture p47: page 1]
