mrrb/tfg/docs/proyecto/memoria/fig/hw_final/buttons_circuit2-eps-converted-to.pdf

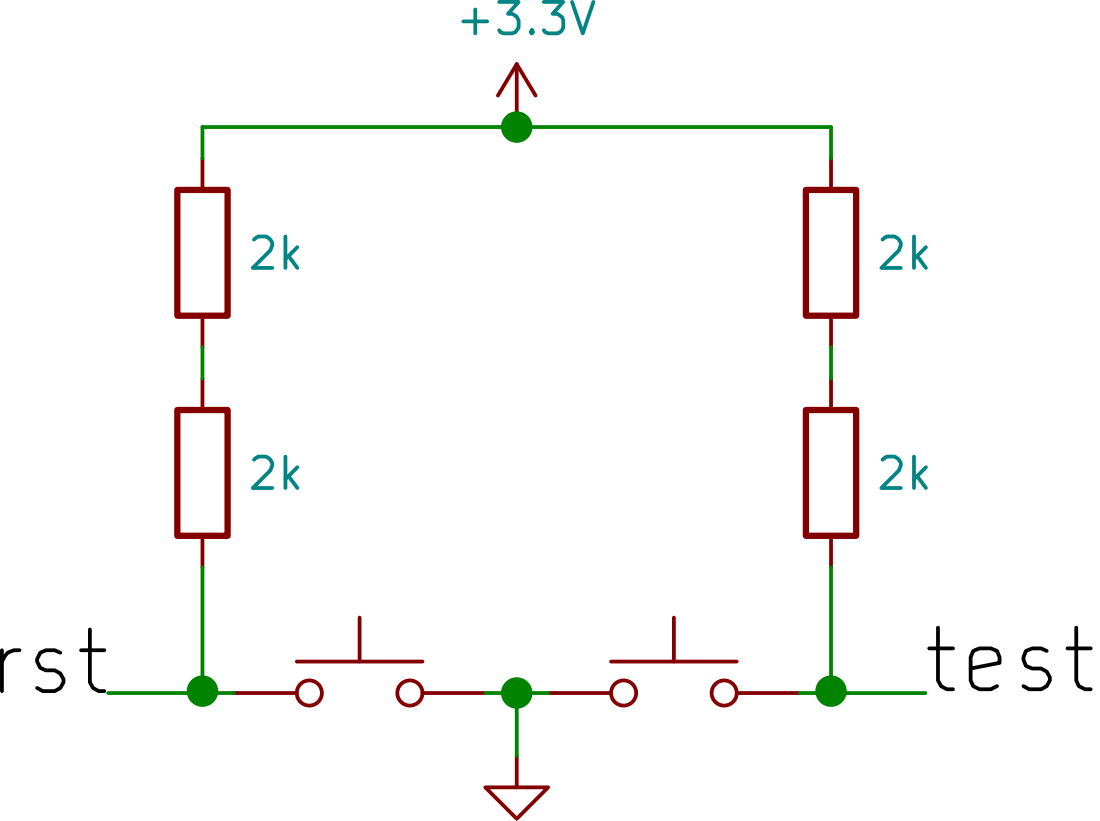
[picture p49: page 1]
