mrrb/tfg/docs/proyecto/memoria/fig/diagramas_FPGA/UART-UART-eps-converted-to.pdf

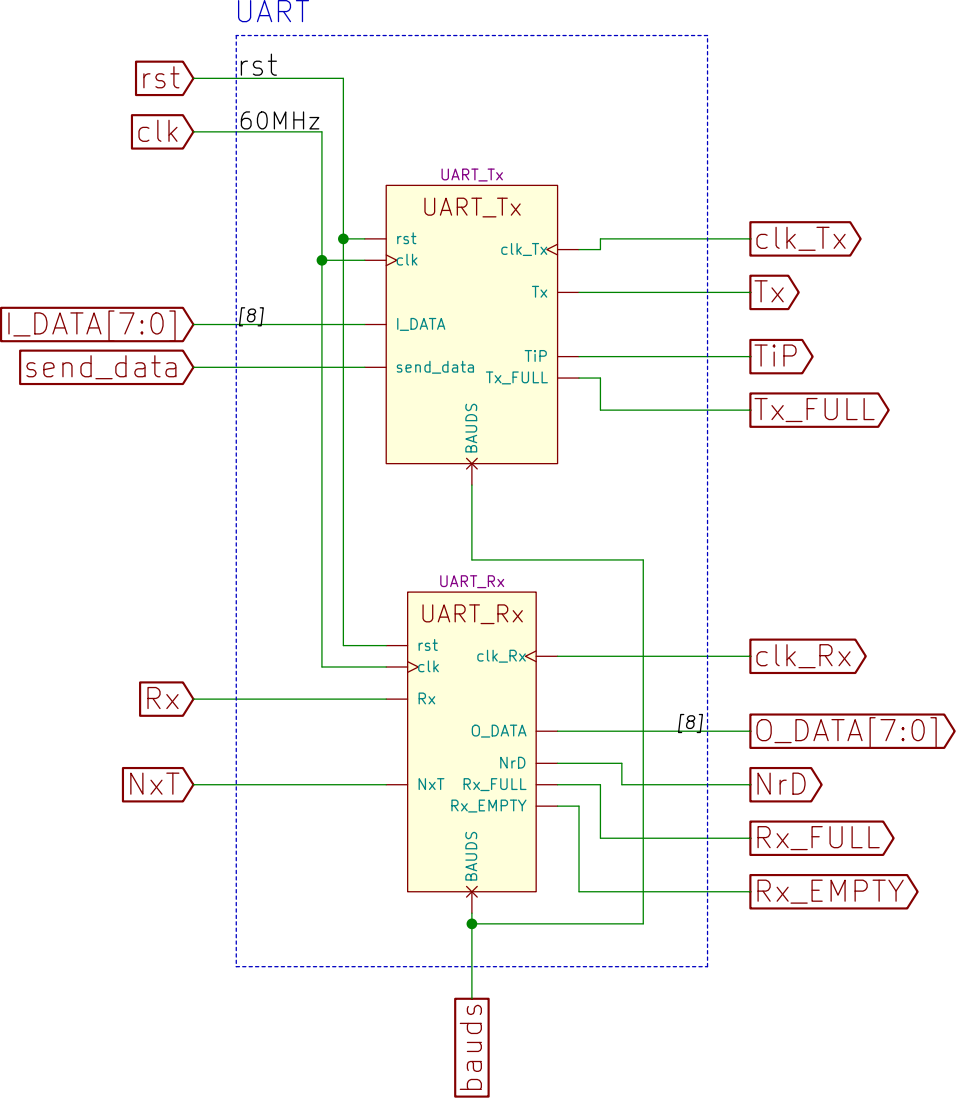
[picture p50: page 1]
