mrrb/tfg/docs/proyecto/memoria/fig/diagramas_FPGA/UART_Rx-UART-UART_Rx-eps-converted-to.pdf

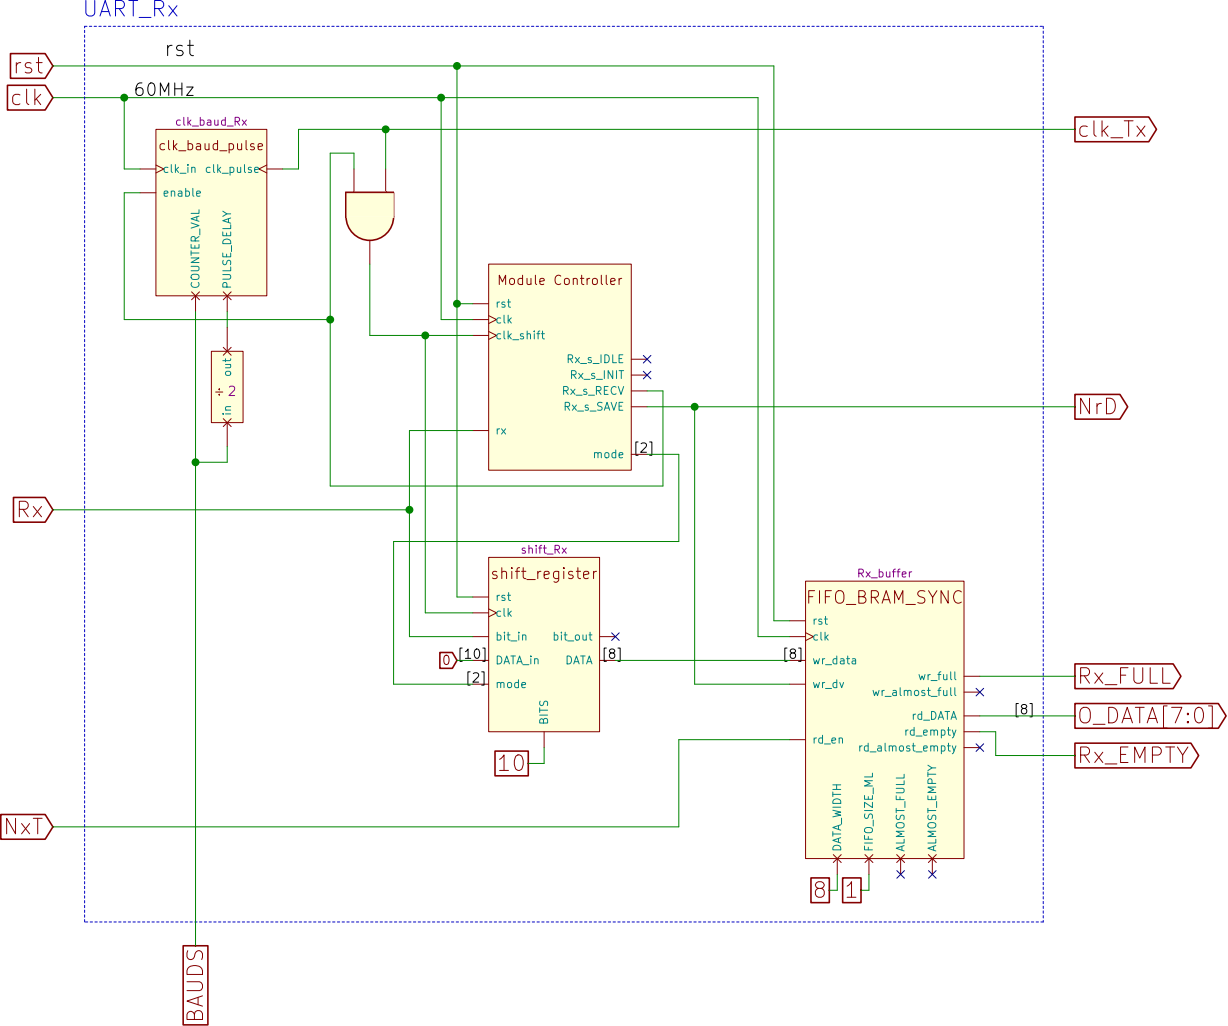
[picture p51: page 1]
