mrrb/tfg/docs/proyecto/memoria/fig/diagramas_FPGA/UART_Tx-UART-UART_Tx-eps-converted-to.pdf

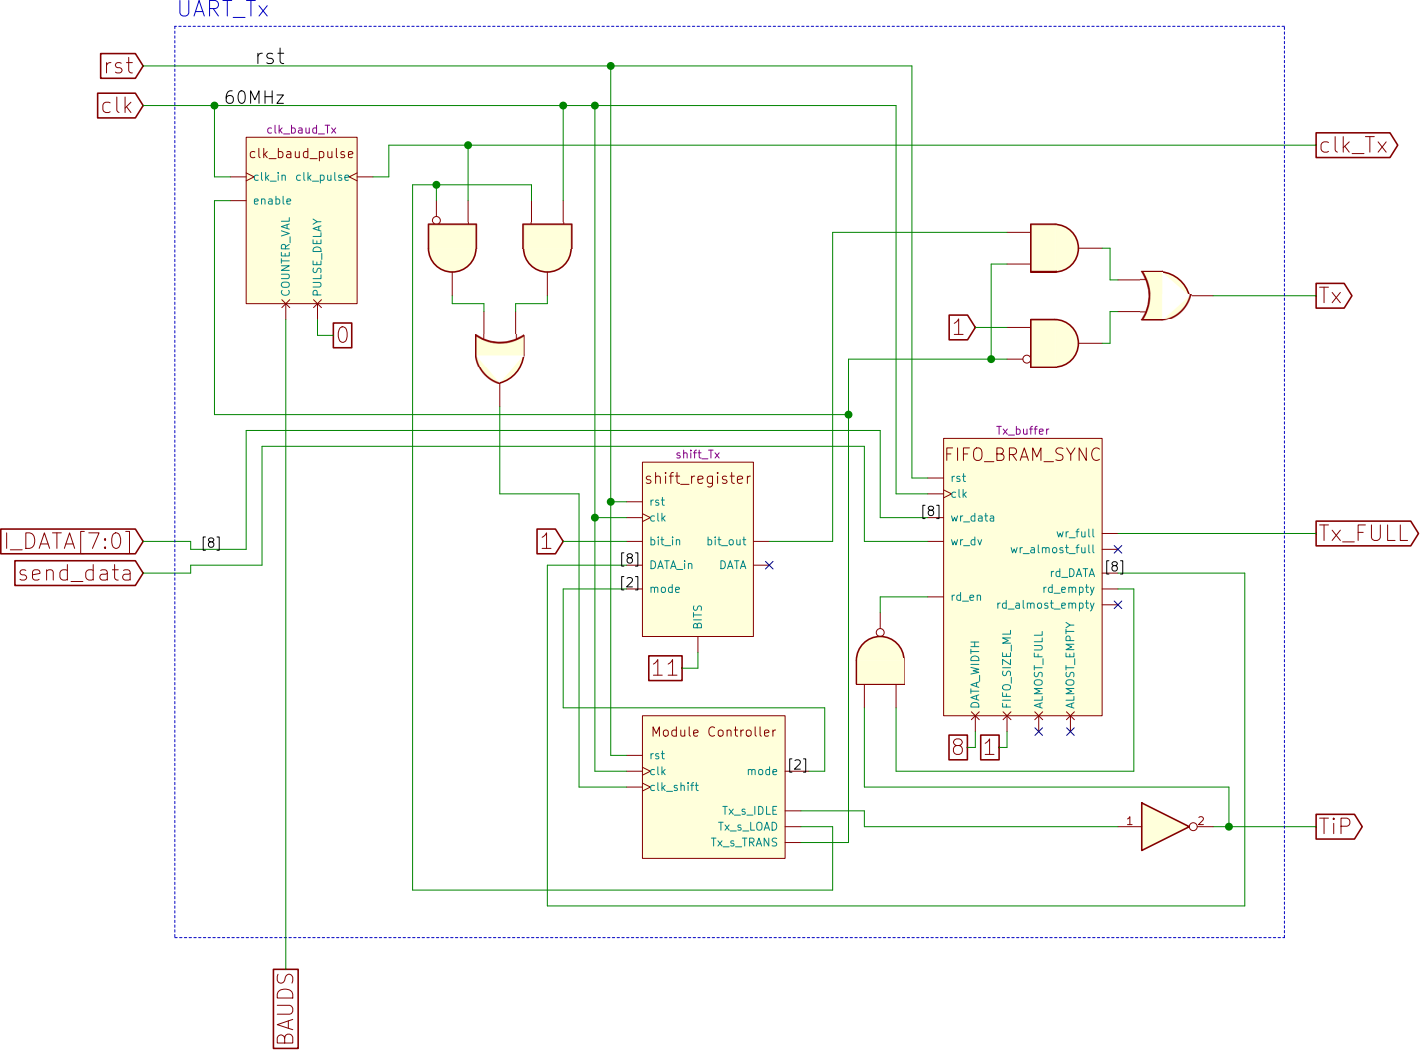
[picture p52: page 1]
