mrrb/tfg/docs/proyecto/memoria/fig/diagramas_FPGA/ULPI-ULPI-eps-converted-to.pdf

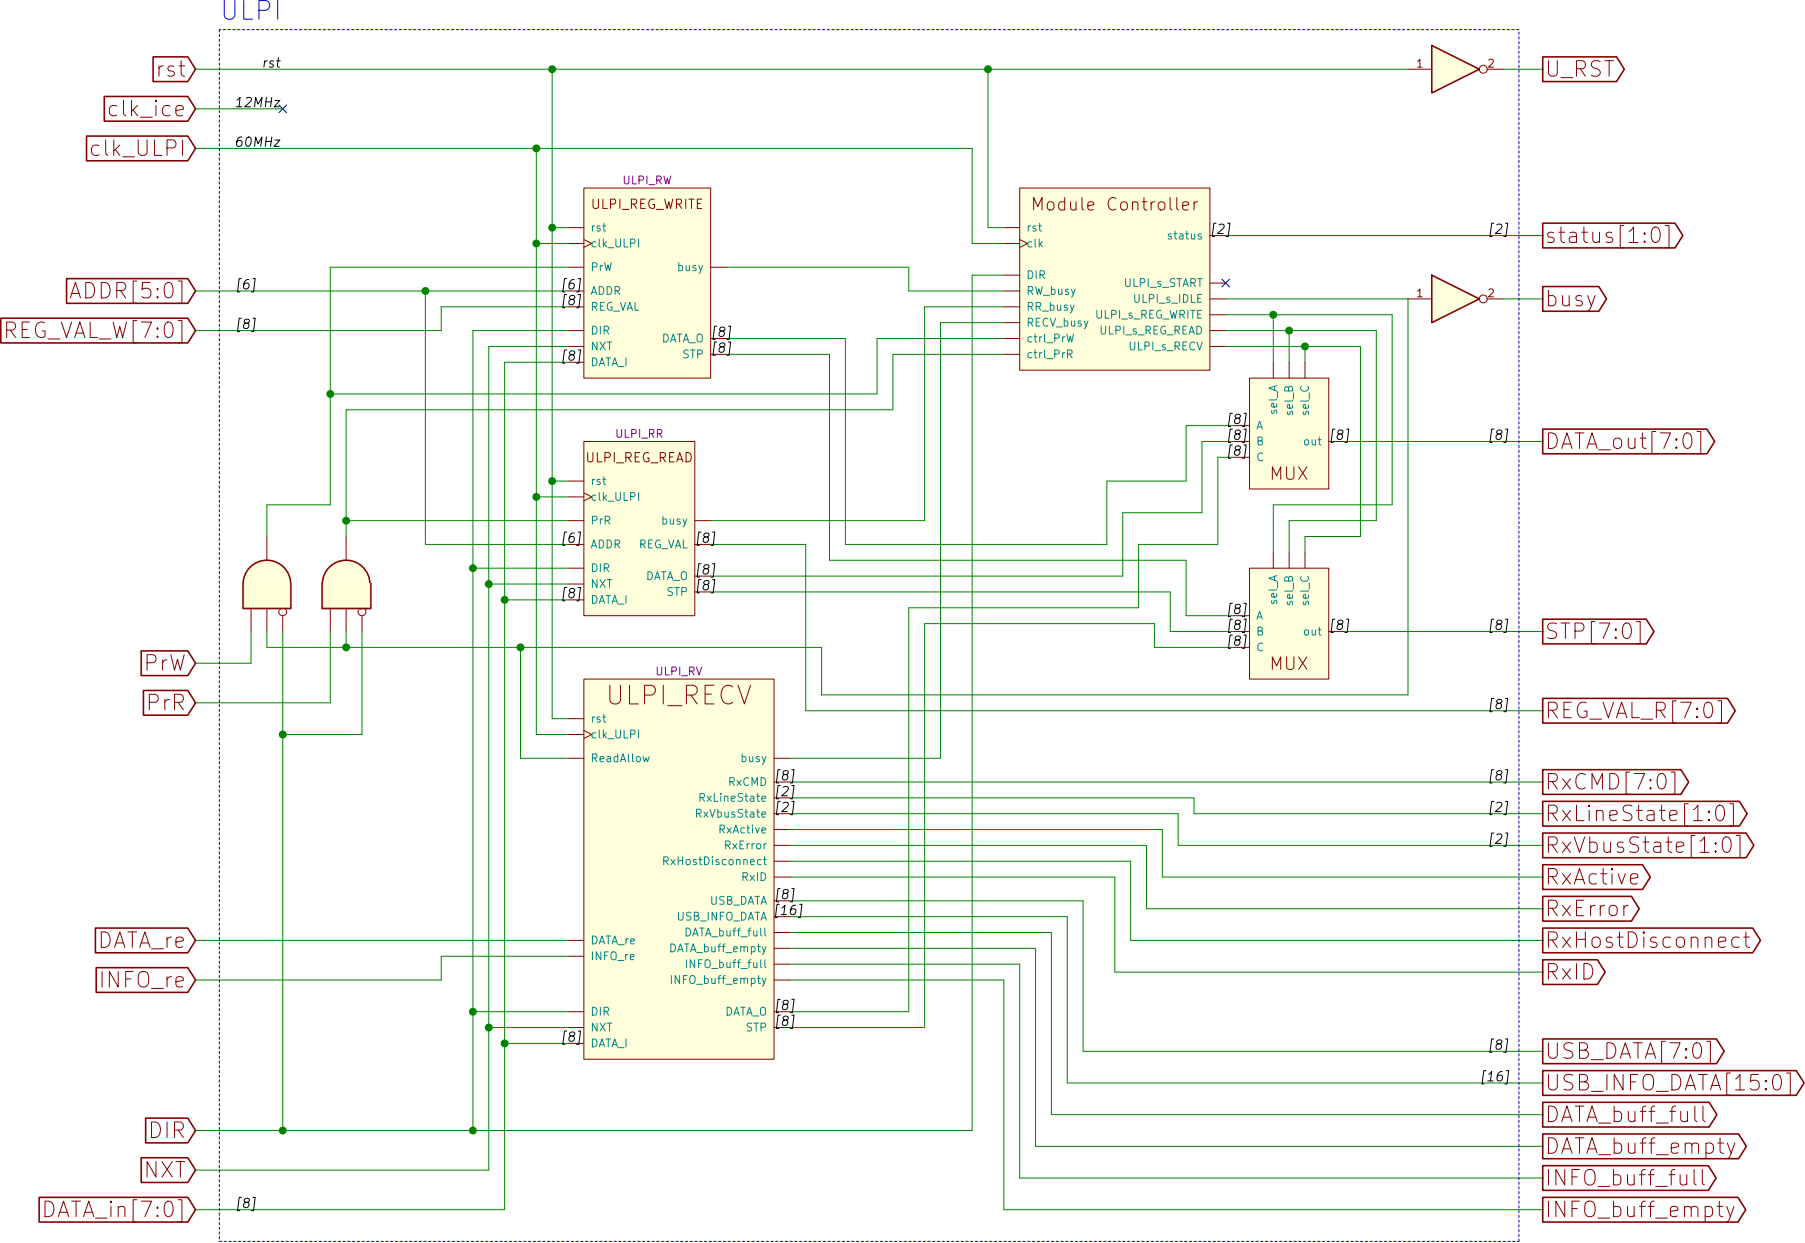
[picture p53: page 1]
