mrrb/tfg/docs/proyecto/memoria/fig/diagramas_FPGA/ULPI_op-ULPI_op-eps-converted-to.pdf

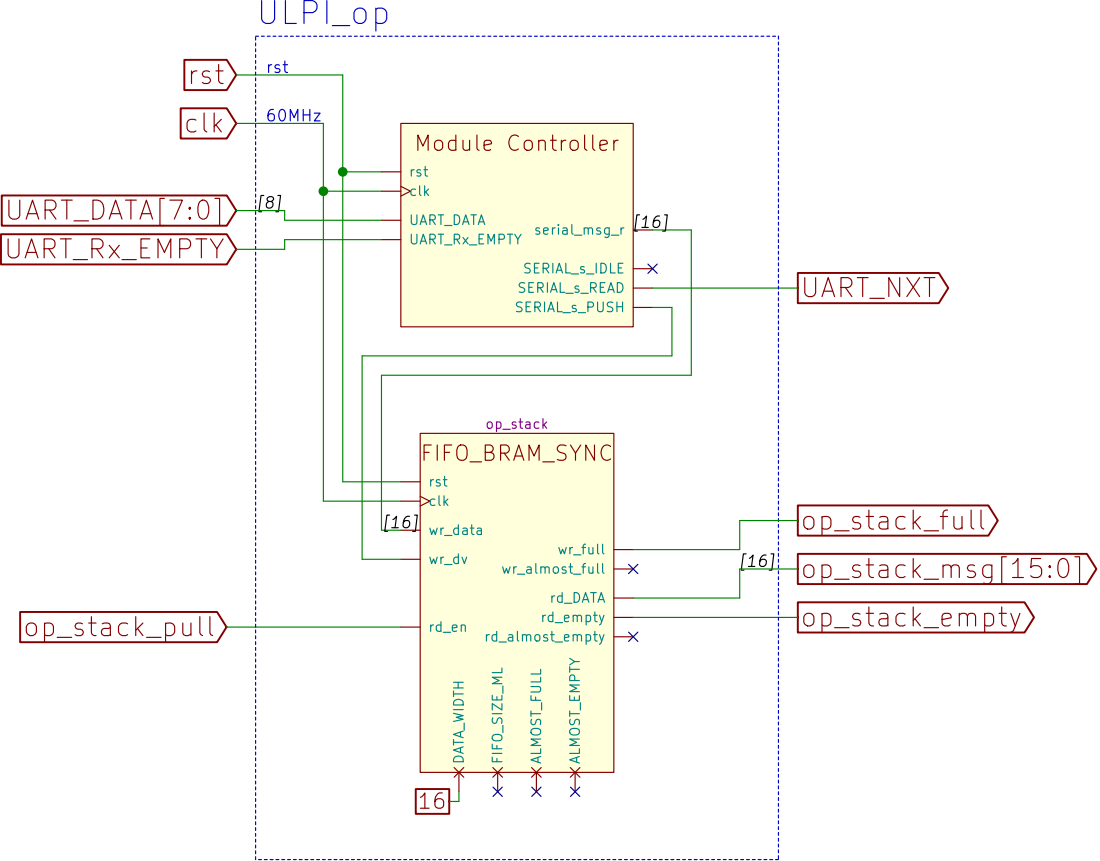
[picture p54: page 1]
