mrrb/tfg/docs/proyecto/memoria/fig/diagramas_FPGA/ULPI_RECV-ULPI-ULPI_RECV-eps-converted-to.pdf

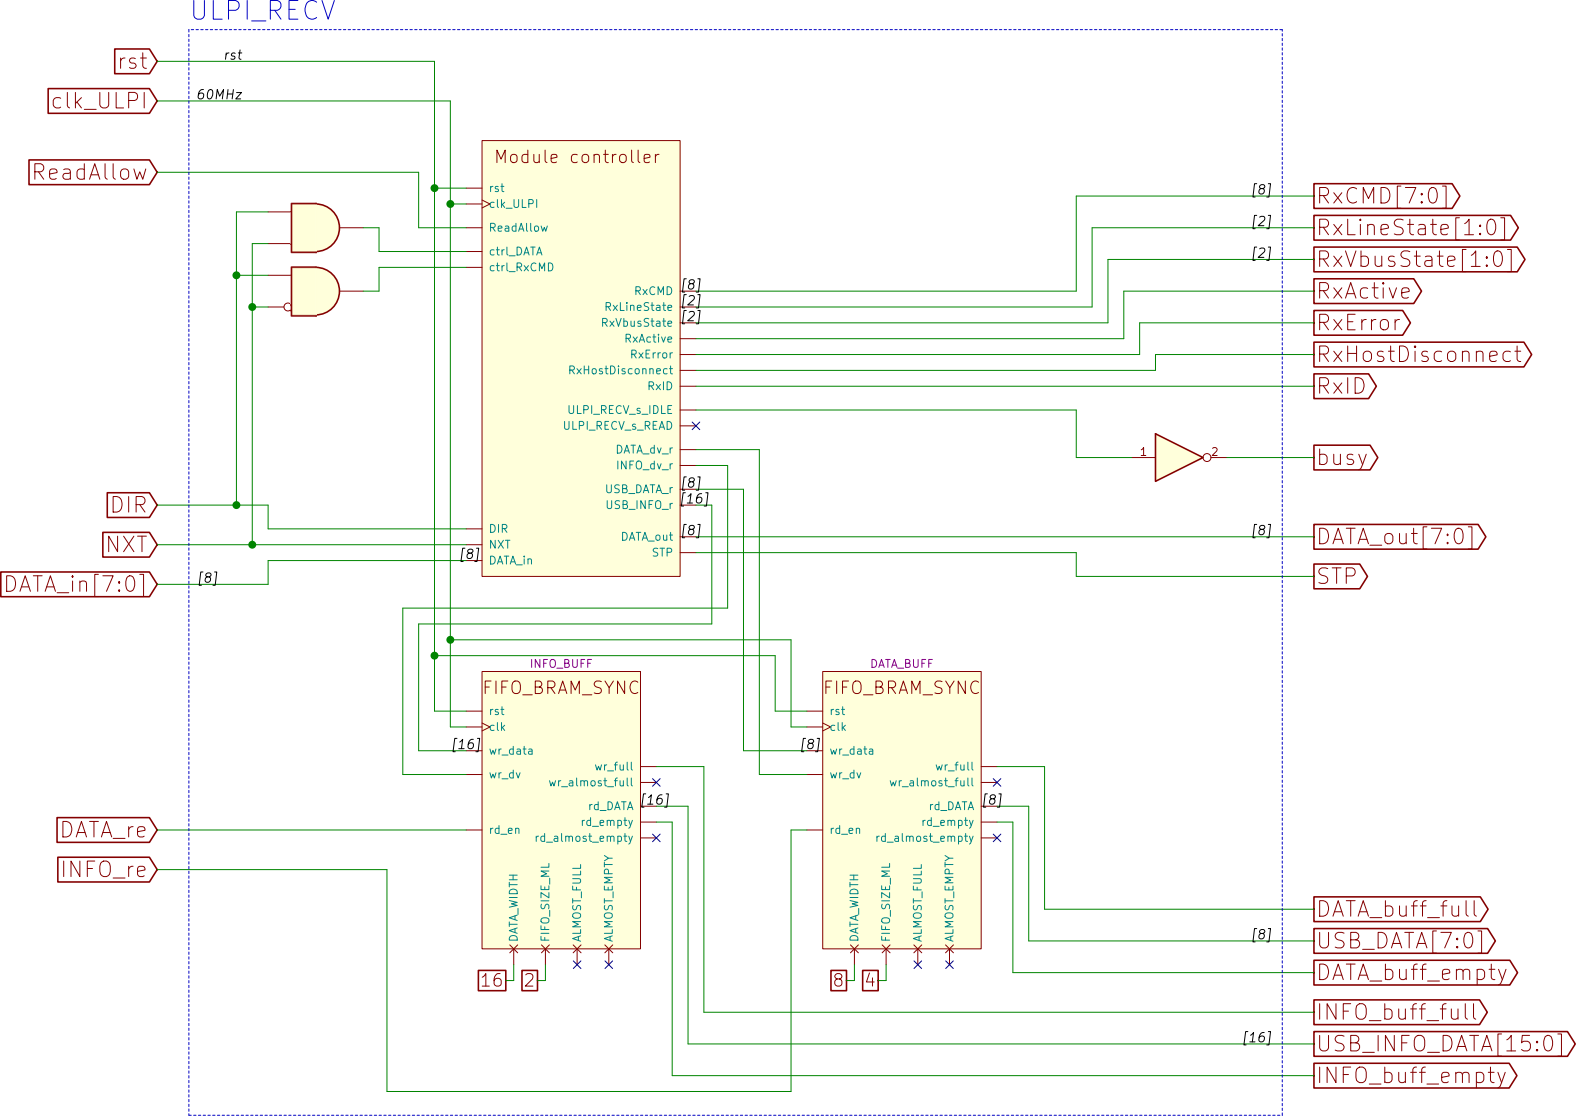
[picture p55: page 1]
