mrrb/tfg/docs/proyecto/memoria/fig/diagramas_FPGA/ULPI_REG_READ-ULPI-ULPI_REG_READ-eps-converted-to.pdf

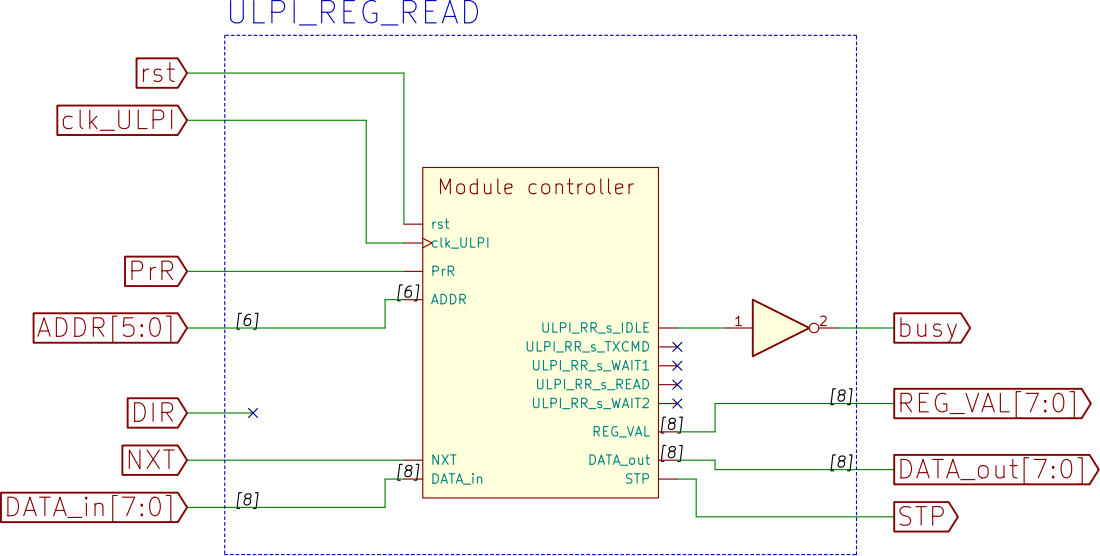
[picture p56: page 1]
