mrrb/tfg/docs/proyecto/memoria/fig/diagramas_FPGA/ULPI_REG_WRITE-ULPI-ULPI_REG_WRITE-eps-converted-to.pdf

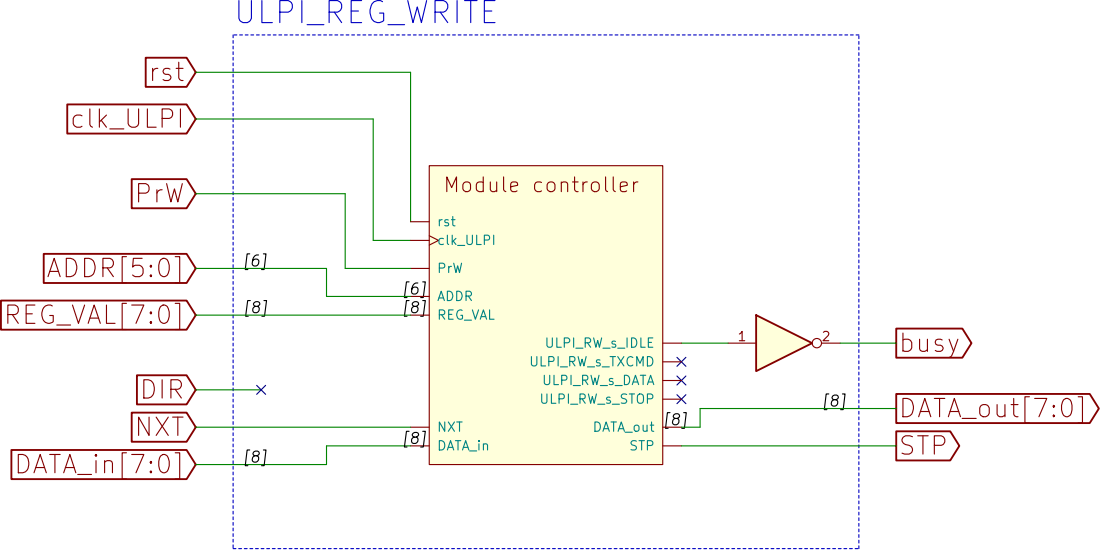
[picture p57: page 1]
