mrrb/tfg/docs/proyecto/memoria/fig/diagramas_FPGA/diagramas_funcionamiento/diagramas_funcionamiento.kicad_pcb

## KiCad design Amur_nutzlast.sch

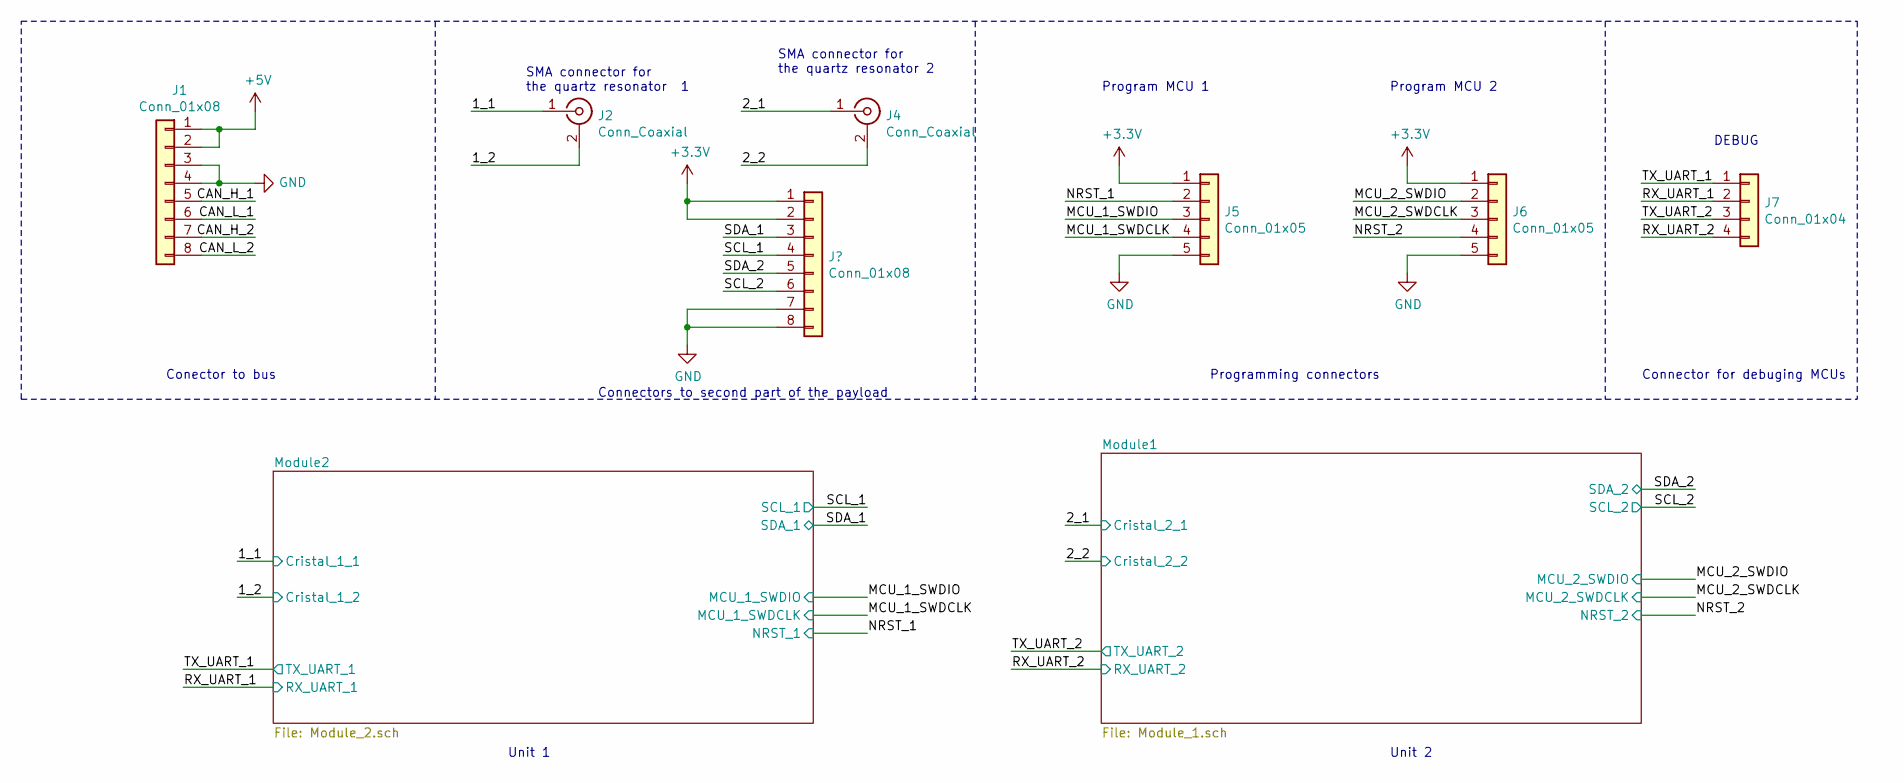
[picture p58: schematic Amur_nutzlast.sch]

Parts:
J1: Conn_01x08
J2, J4: Conn_Coaxial
J5, J6: Conn_01x05
J7: Conn_01x04

Connections:
1_1: J2.1 (In)
1_2: J2.2 (Ext)
2_1: J4.1 (In)
2_2: J4.2 (Ext)
+3.3V: J5.1, J6.1
+5V: J1.1, J1.2
CAN_H_1: J1.5
CAN_H_2: J1.7
CAN_L_1: J1.6
CAN_L_2: J1.8
GND: J1.3, J1.4, J5.5, J6.5
MCU_1_SWDCLK: J5.4
MCU_1_SWDIO: J5.3
MCU_2_SWDCLK: J6.3
MCU_2_SWDIO: J6.2
NRST_1: J5.2
NRST_2: J6.4
RX_UART_1: J7.2
RX_UART_2: J7.4
TX_UART_1: J7.1
TX_UART_2: J7.3

Notes on the sheet:
SMA connector for the quartz resonator 1
SMA connector for the quartz resonator 2
Conector to bus
Connectors to second part of the payload
Program MCU 1
Program MCU 2
Programming connectors
DEBUG
Connector for debuging MCUs
Unit 1
Unit 2
