mrrb/tfg/docs/proyecto/memoria/fig/diagramas_FPGA/diagramas_funcionamiento/diagramas_funcionamiento.kicad_pcb

## KiCad design Frequency generator_1.1.sch

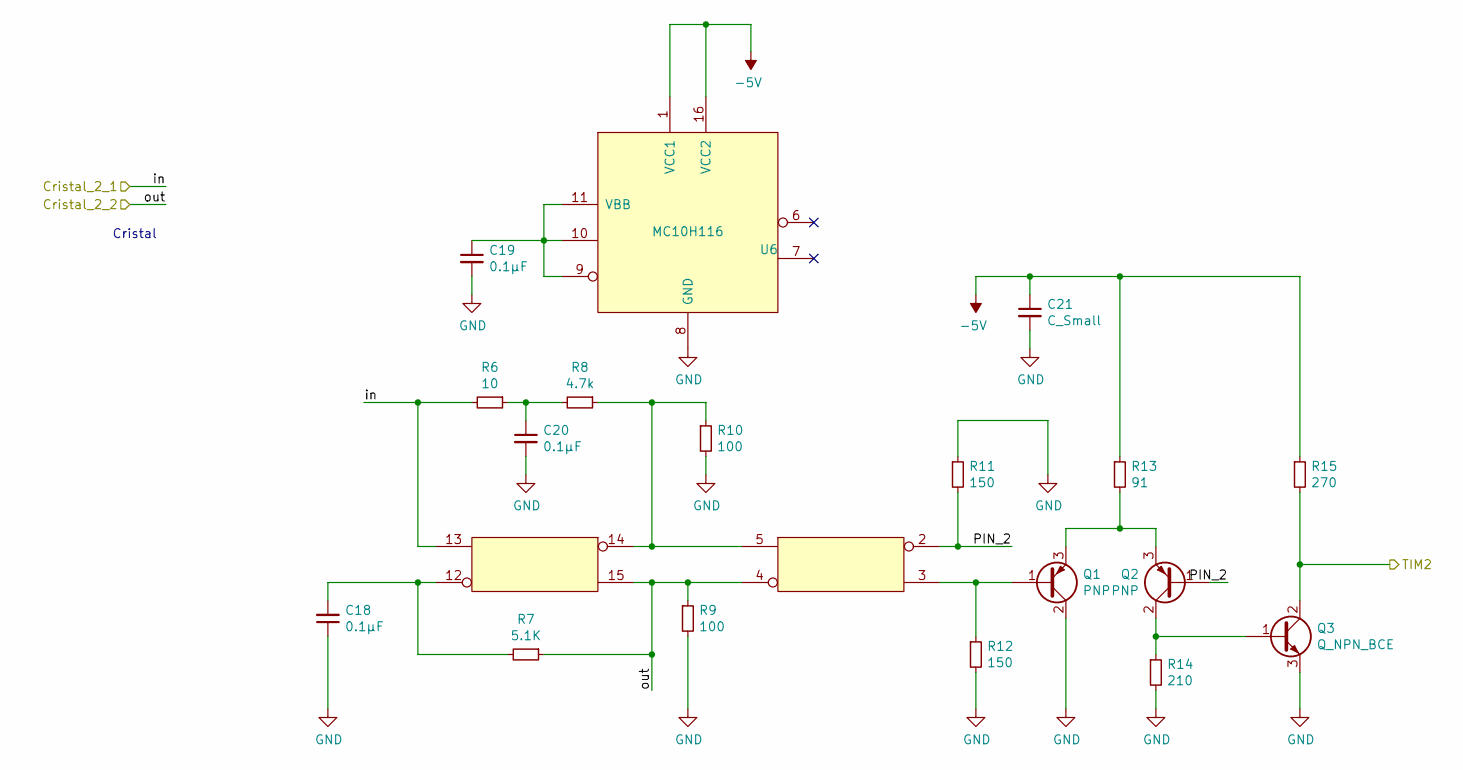
[picture p59: schematic Frequency generator_1.1.sch]

Parts:
C36, C37, C38: 0.1µF
C39: C_Small
Q7, Q8: PNP
Q9: Q_NPN_BCE
R25: 10
R26: 5.1K
R27: 4.7k
R28, R29: 100
R30, R31: 150
R32: 91
R33: 210
R34: 270
U11: MC10H116; SOIC-16_3.9x9.9mm_P1.27mm

Connections:
-5V: C39.1, R32.1, R34.1, U11.1 (VCC1), U11.16 (VCC2)
Cristal_2_1: R25.2, U11.13
Cristal_2_2: R26.1, R28.1, U11.4, U11.15
GND: C36.1, C37.2, C38.2, C39.2, Q7.2 (C), Q9.3 (E), R28.2, R29.2, R30.1, R31.2, R33.2, U11.8 (GND)
unnamed: C36.2, R26.2, U11.12
unnamed: C37.1, U11.9, U11.10, U11.11 (VBB)
unnamed: C38.1, R25.1, R27.2
unnamed: Q7.1 (B), R31.1, U11.3
unnamed: Q7.3 (E), Q8.3 (E), R32.2
unnamed: Q8.2 (C), Q9.1 (B), R33.1
unnamed: R27.1, R29.1, U11.5, U11.14
PIN_2: Q8.1 (B), R30.2, U11.2
TIM2: Q9.2 (C), R34.2

Notes on the sheet:
Cristal
