mrrb/tfg/docs/proyecto/memoria/fig/diagramas_FPGA/diagramas_funcionamiento/diagramas_funcionamiento.kicad_pcb

## KiCad design Frequency generator_1.2.sch

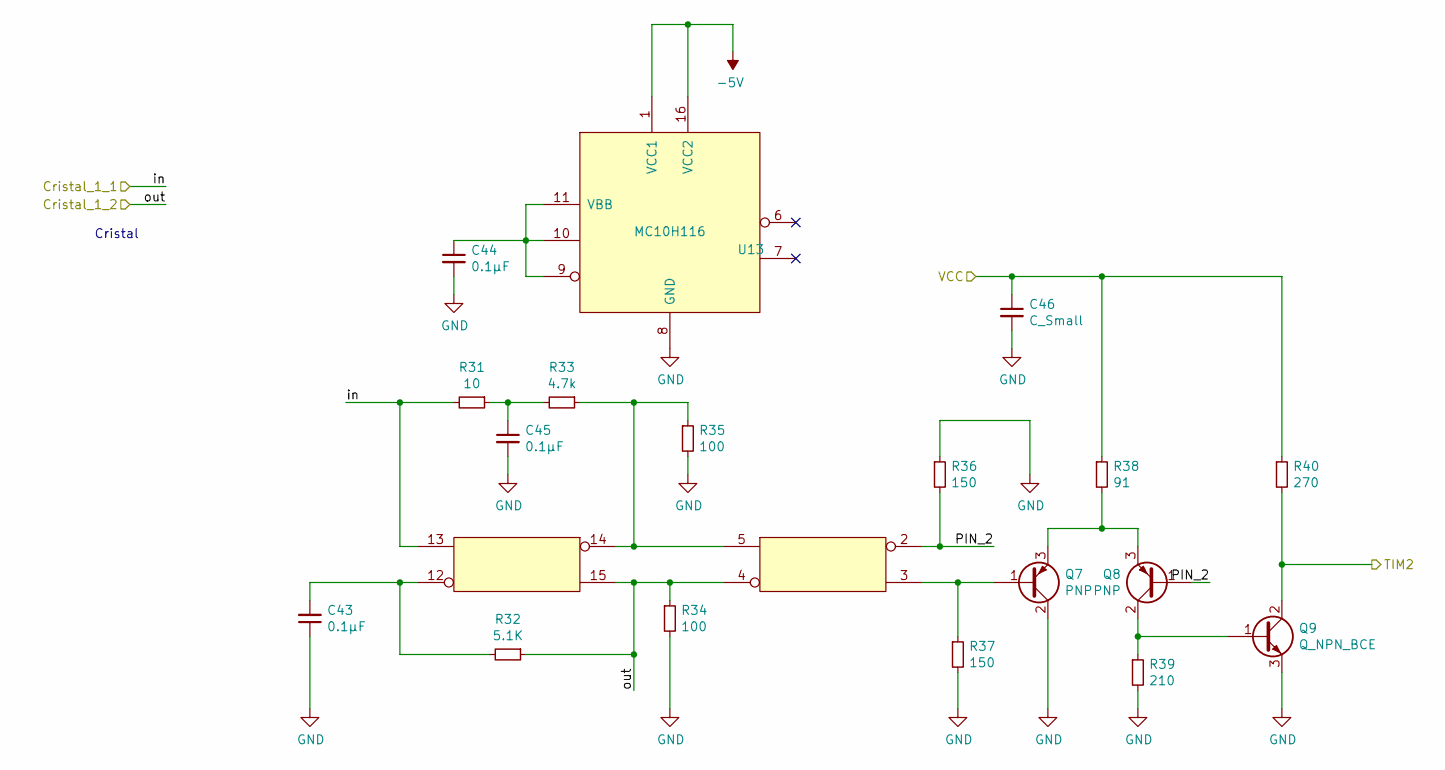
[picture p60: schematic Frequency generator_1.2.sch]

Parts:
C18, C19, C20: 0.1µF
C21: C_Small
Q1, Q2: PNP
Q3: Q_NPN_BCE
R5: 10
R6: 5.1K
R7: 4.7k
R8, R9: 100
R10, R11: 150
R12: 91
R13: 210
R14: 270
U8: MC10H116; SOIC-16_3.9x9.9mm_P1.27mm

Connections:
-5V: U8.1 (VCC1), U8.16 (VCC2)
Cristal_1_1: R5.2, U8.13
Cristal_1_2: R6.1, R8.1, U8.4, U8.15
GND: C18.1, C19.2, C20.2, C21.2, Q1.2 (C), Q3.3 (E), R8.2, R9.2, R10.1, R11.2, R13.2, U8.8 (GND)
unnamed: C18.2, R6.2, U8.12
unnamed: C19.1, U8.9, U8.10, U8.11 (VBB)
unnamed: C20.1, R5.1, R7.2
unnamed: Q1.1 (B), R11.1, U8.3
unnamed: Q1.3 (E), Q2.3 (E), R12.2
unnamed: Q2.2 (C), Q3.1 (B), R13.1
unnamed: R7.1, R9.1, U8.5, U8.14
PIN_2: Q2.1 (B), R10.2, U8.2
TIM2: Q3.2 (C), R14.2
VCC: C21.1, R12.1, R14.1

Notes on the sheet:
Cristal
