mrrb/tfg/docs/proyecto/memoria/fig/diagramas_FPGA/diagramas_funcionamiento/diagramas_funcionamiento.kicad_pcb

## KiCad design Frequency generator_2.1.sch

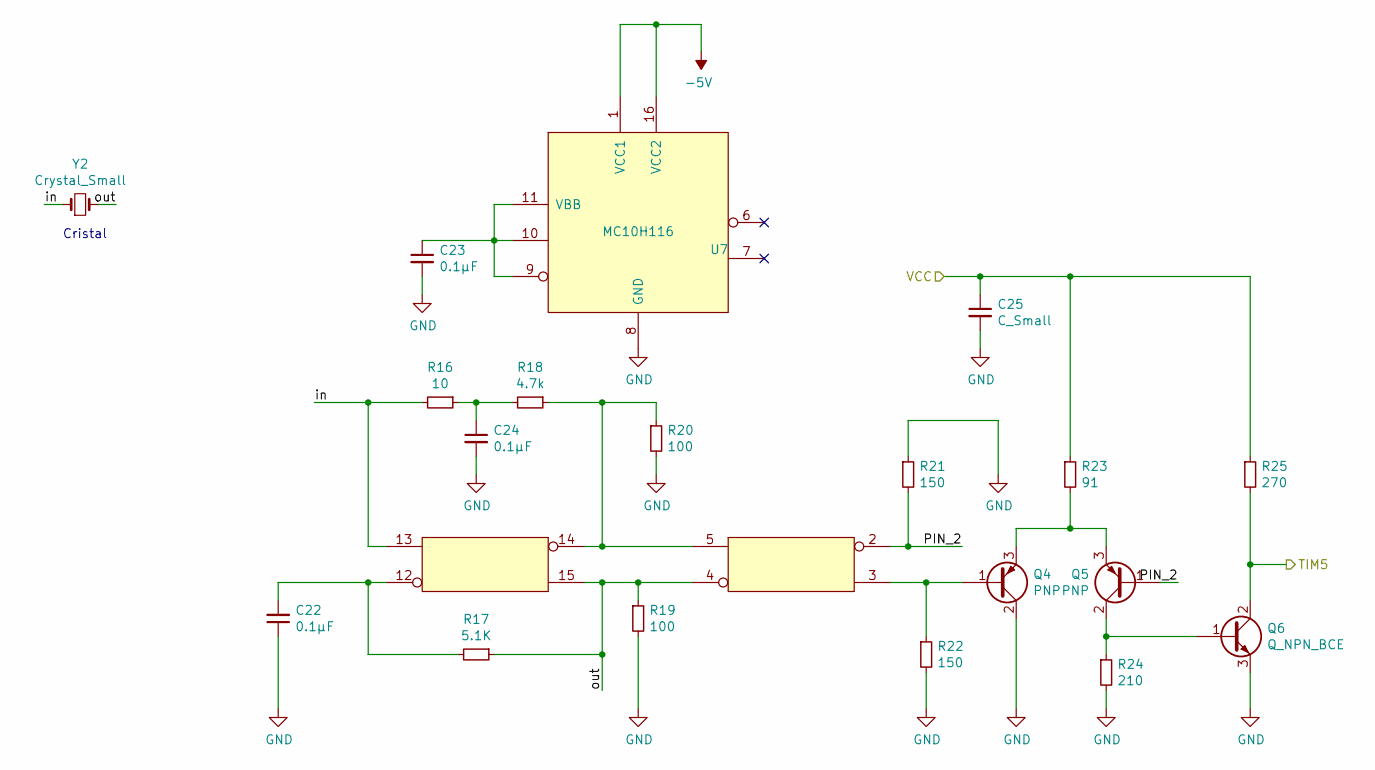
[picture p61: schematic Frequency generator_2.1.sch]

Parts:
C40, C41, C42: 0.1µF
C43: C_Small
Q10, Q11: PNP
Q12: Q_NPN_BCE
R35: 10
R36: 5.1K
R37: 4.7k
R38, R39: 100
R40, R41: 150
R42: 91
R43: 210
R44: 270
U12: MC10H116; SOIC-16_3.9x9.9mm_P1.27mm
Y2: Crystal_Small

Connections:
-5V: U12.1 (VCC1), U12.16 (VCC2)
GND: C40.1, C41.2, C42.2, C43.2, Q10.2 (C), Q12.3 (E), R38.2, R39.2, R40.1, R41.2, R43.2, U12.8 (GND)
unnamed: C40.2, R36.2, U12.12
unnamed: C41.1, U12.9, U12.10, U12.11 (VBB)
unnamed: C42.1, R35.1, R37.2
unnamed: Q10.1 (B), R41.1, U12.3
unnamed: Q10.3 (E), Q11.3 (E), R42.2
unnamed: Q11.2 (C), Q12.1 (B), R43.1
unnamed: R37.1, R39.1, U12.5, U12.14
PIN_2: Q11.1 (B), R40.2, U12.2
TIM5: Q12.2 (C), R44.2
VCC: C43.1, R42.1, R44.1
in: R35.2, U12.13, Y2.1
out: R36.1, R38.1, U12.4, U12.15, Y2.2

Notes on the sheet:
Cristal
