mrrb/tfg/docs/proyecto/memoria/fig/diagramas_FPGA/diagramas_funcionamiento/diagramas_funcionamiento.kicad_pcb

## KiCad design Frequency generator_2.2.sch

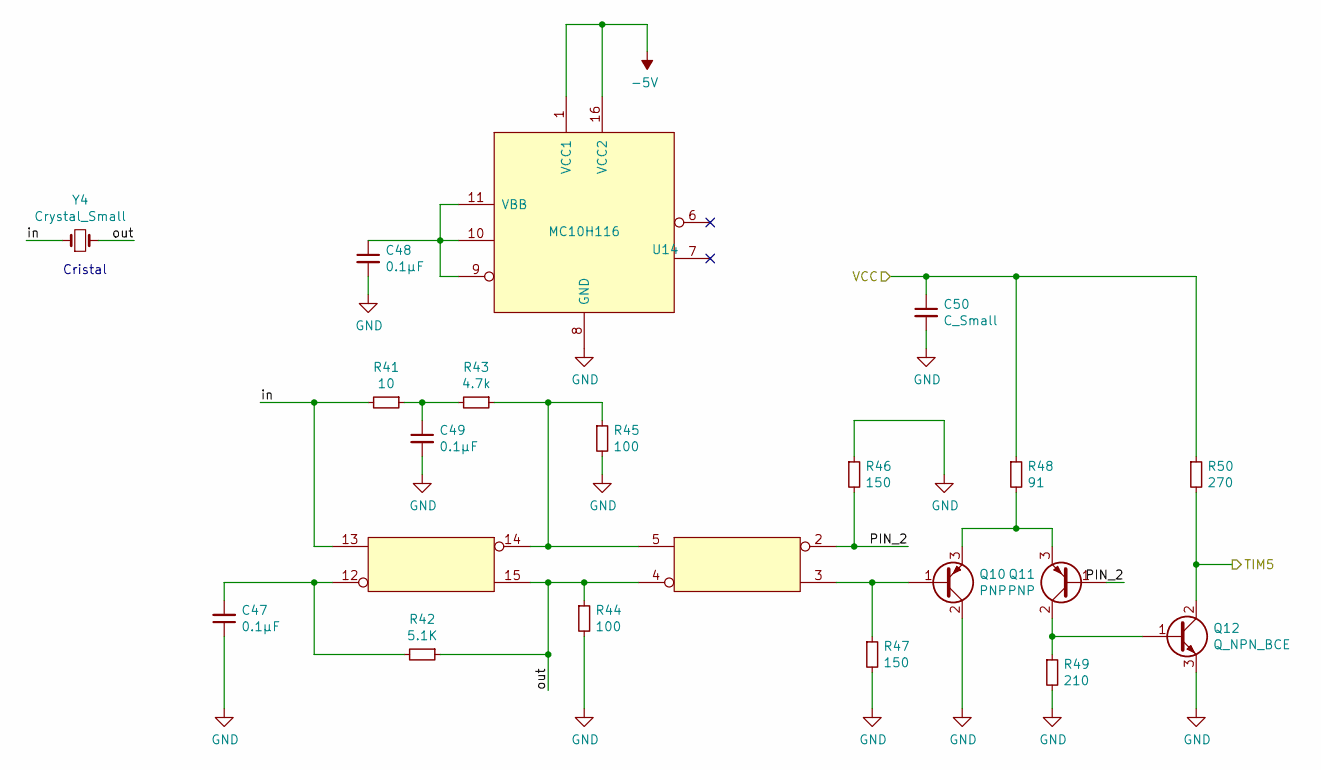
[picture p62: schematic Frequency generator_2.2.sch]

Parts:
C22, C23, C24: 0.1µF
C25: C_Small
Q4, Q5: PNP
Q6: Q_NPN_BCE
R15: 10
R16: 5.1K
R17: 4.7k
R18, R19: 100
R20, R21: 150
R22: 91
R23: 210
R24: 270
U9: MC10H116; SOIC-16_3.9x9.9mm_P1.27mm
Y4: Crystal_Small

Connections:
-5V: U9.1 (VCC1), U9.16 (VCC2)
GND: C22.1, C23.2, C24.2, C25.2, Q4.2 (C), Q6.3 (E), R18.2, R19.2, R20.1, R21.2, R23.2, U9.8 (GND)
unnamed: C22.2, R16.2, U9.12
unnamed: C23.1, U9.9, U9.10, U9.11 (VBB)
unnamed: C24.1, R15.1, R17.2
unnamed: Q4.1 (B), R21.1, U9.3
unnamed: Q4.3 (E), Q5.3 (E), R22.2
unnamed: Q5.2 (C), Q6.1 (B), R23.1
unnamed: R17.1, R19.1, U9.5, U9.14
PIN_2: Q5.1 (B), R20.2, U9.2
TIM5: Q6.2 (C), R24.2
VCC: C25.1, R22.1, R24.1
in: R15.2, U9.13, Y4.1
out: R16.1, R18.1, U9.4, U9.15, Y4.2

Notes on the sheet:
Cristal
