mrrb/tfg/docs/proyecto/memoria/fig/diagramas_FPGA/diagramas_funcionamiento/diagramas_funcionamiento.kicad_pcb

## KiCad design MCU1_.sch

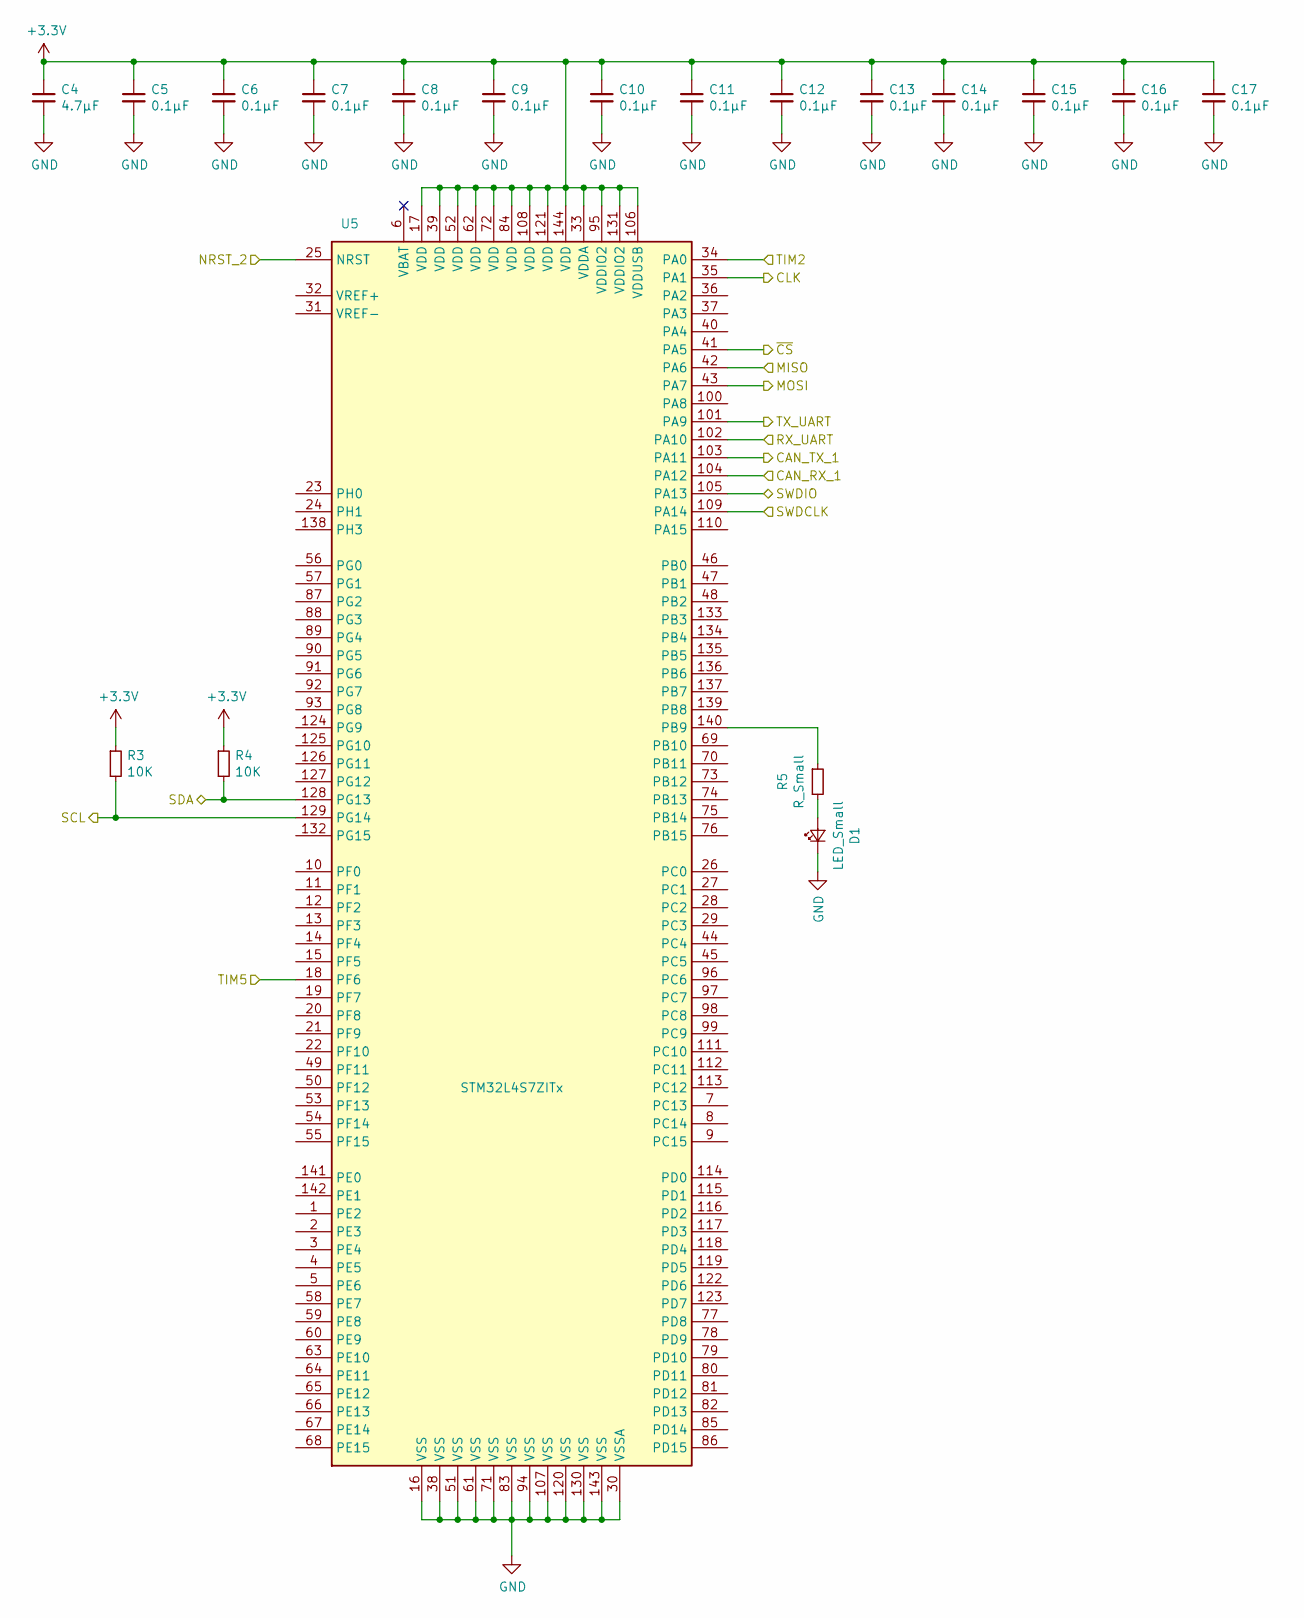
[picture p63: schematic MCU1_.sch]

Parts:
C4: 4.7µF
C5, C6, C7, C8, C9, C10, C11, C12, C13, C14, C15, C16, C17: 0.1µF
D1: LED_Small
R3, R4: 10K
R5: R_Small
U5: STM32L4S7ZITx; LQFP-144_20x20mm_P0.5mm

Connections:
+3.3V: C4.1, C5.1, C6.1, C7.1, C8.1, C9.1, C10.1, C11.1, C12.1, C13.1, C14.1, C15.1, C16.1, C17.1, R3.1, R4.1, U5.17 (VDD), U5.33 (VDDA), U5.39 (VDD), U5.52 (VDD), U5.62 (VDD), U5.72 (VDD), U5.84 (VDD), U5.95 (VDDIO2), U5.106 (VDDUSB), U5.108 (VDD), U5.121 (VDD), U5.131 (VDDIO2), U5.144 (VDD)
CAN_RX_1: U5.104 (PA12)
CAN_TX_1: U5.103 (PA11)
CLK: U5.35 (PA1)
GND: C4.2, C5.2, C6.2, C7.2, C8.2, C9.2, C10.2, C11.2, C12.2, C13.2, C14.2, C15.2, C16.2, C17.2, D1.1 (K), U5.16 (VSS), U5.30 (VSSA), U5.38 (VSS), U5.51 (VSS), U5.61 (VSS), U5.71 (VSS), U5.83 (VSS), U5.94 (VSS), U5.107 (VSS), U5.120 (VSS), U5.130 (VSS), U5.143 (VSS)
MISO: U5.42 (PA6)
MOSI: U5.43 (PA7)
NRST_2: U5.25 (NRST)
unnamed: D1.2 (A), R5.2
unnamed: R5.1, U5.140 (PB9)
RX_UART: U5.102 (PA10)
SCL: R3.2, U5.129 (PG14)
SDA: R4.2, U5.128 (PG13)
SWDCLK: U5.109 (PA14)
SWDIO: U5.105 (PA13)
TIM2: U5.34 (PA0)
TIM5: U5.18 (PF6)
TX_UART: U5.101 (PA9)
~CS: U5.41 (PA5)
