mrrb/tfg/docs/proyecto/memoria/fig/diagramas_FPGA/diagramas_funcionamiento/diagramas_funcionamiento.kicad_pcb

## KiCad design MCU2_.sch

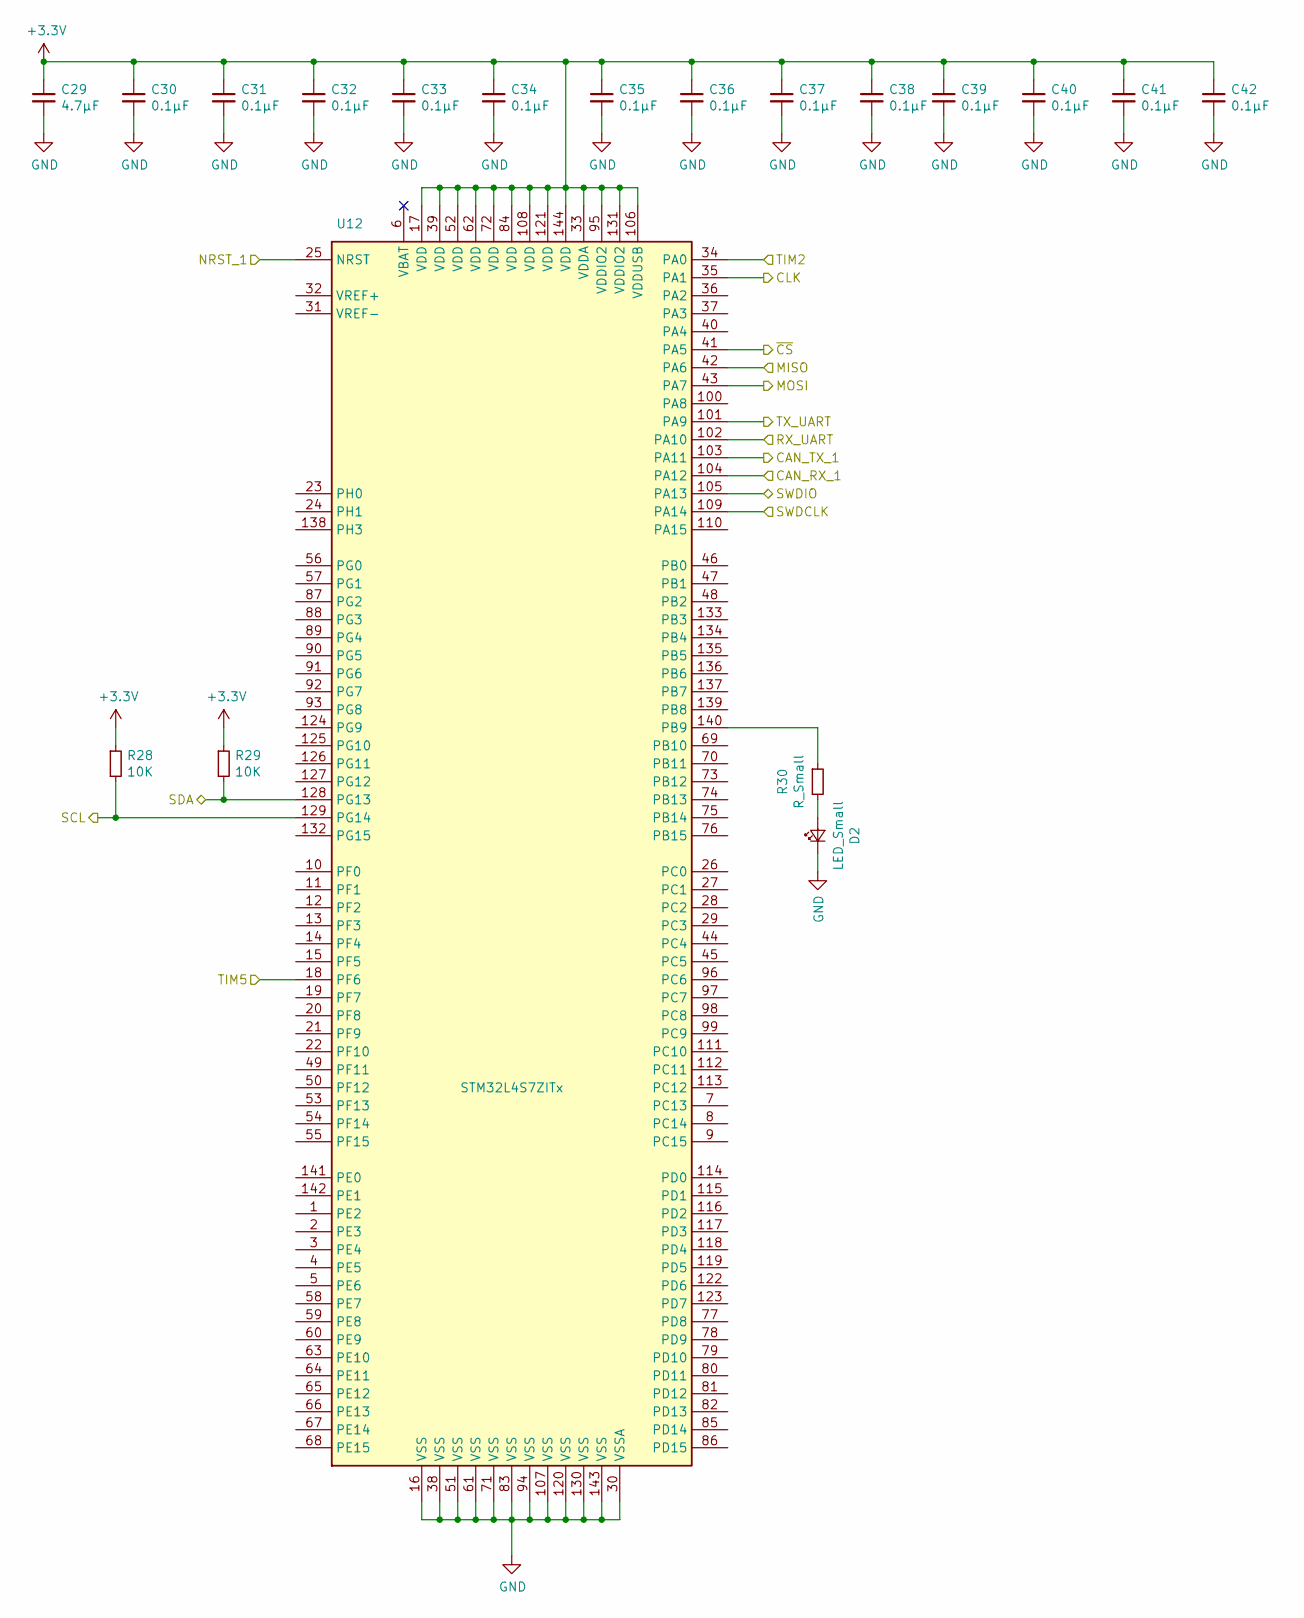
[picture p64: schematic MCU2_.sch]

Parts:
C8: 4.7µF
C9, C10, C11, C12, C13, C14, C15, C16, C17, C39, C40, C41, C42: 0.1µF
D2: LED_Small
R28, R29: 10K
R30: R_Small
U12: STM32L4S7ZITx; LQFP-144_20x20mm_P0.5mm

Connections:
+3.3V: C8.1, C9.1, C10.1, C11.1, C12.1, C13.1, C14.1, C15.1, C16.1, C17.1, C39.1, C40.1, C41.1, C42.1, R28.1, R29.1, U12.17 (VDD), U12.33 (VDDA), U12.39 (VDD), U12.52 (VDD), U12.62 (VDD), U12.72 (VDD), U12.84 (VDD), U12.95 (VDDIO2), U12.106 (VDDUSB), U12.108 (VDD), U12.121 (VDD), U12.131 (VDDIO2), U12.144 (VDD)
CAN_RX_1: U12.104 (PA12)
CAN_TX_1: U12.103 (PA11)
CLK: U12.35 (PA1)
GND: C8.2, C9.2, C10.2, C11.2, C12.2, C13.2, C14.2, C15.2, C16.2, C17.2, C39.2, C40.2, C41.2, C42.2, D2.1 (K), U12.16 (VSS), U12.30 (VSSA), U12.38 (VSS), U12.51 (VSS), U12.61 (VSS), U12.71 (VSS), U12.83 (VSS), U12.94 (VSS), U12.107 (VSS), U12.120 (VSS), U12.130 (VSS), U12.143 (VSS)
MISO: U12.42 (PA6)
MOSI: U12.43 (PA7)
NRST_1: U12.25 (NRST)
unnamed: D2.2 (A), R30.2
unnamed: R30.1, U12.140 (PB9)
RX_UART: U12.102 (PA10)
SCL: R28.2, U12.129 (PG14)
SDA: R29.2, U12.128 (PG13)
SWDCLK: U12.109 (PA14)
SWDIO: U12.105 (PA13)
TIM2: U12.34 (PA0)
TIM5: U12.18 (PF6)
TX_UART: U12.101 (PA9)
~CS: U12.41 (PA5)
