mrrb/tfg/docs/proyecto/memoria/fig/diagramas_FPGA/diagramas_funcionamiento/diagramas_funcionamiento.kicad_pcb

## KiCad design Module_1.sch

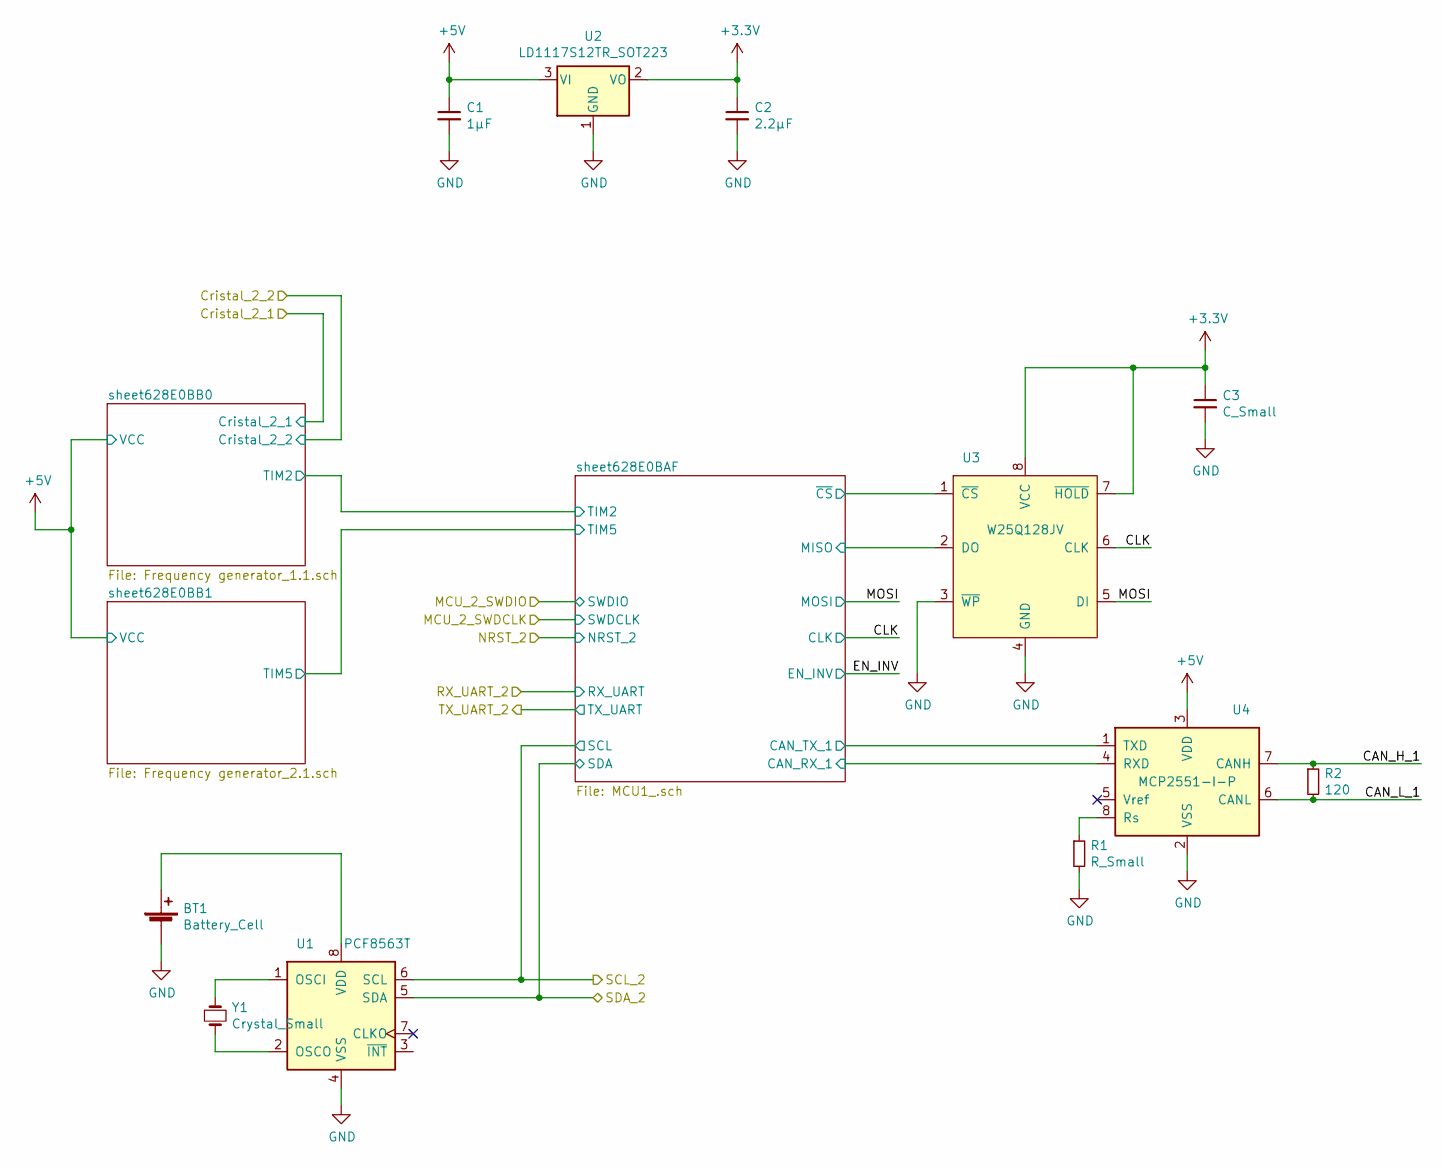
[picture p65: schematic Module_1.sch]

Parts:
BT1: Battery_Cell
C1: 1µF
C2: 2.2µF
C3: C_Small
R1: R_Small
R2: 120
U1: PCF8563T; SOIC-8_3.9x4.9mm_P1.27mm
U2: LD1117S12TR_SOT223; SOT-223-3_TabPin2
U3: W25Q128JV
U4: MCP2551-I-P; DIP-8_W7.62mm
Y1: Crystal_Small

Connections:
+3.3V: C2.1, C3.1, U2.2 (VO), U3.7 (~HOLD), U3.8 (VCC)
+5V: C1.1, U2.3 (VI), U4.3 (VDD)
CAN_H_1: R2.1, U4.7 (CANH)
CAN_L_1: R2.2, U4.6 (CANL)
CAN_RX_1: U4.4 (RXD)
CAN_TX_1: U4.1 (TXD)
CLK: U3.6 (CLK)
GND: BT1.2 (-), C1.2, C2.2, C3.2, R1.2, U1.4 (VSS), U2.1 (GND), U3.3 (~WP), U3.4 (GND), U4.2 (VSS)
MISO: U3.2 (DO)
MOSI: U3.5 (DI)
unnamed: BT1.1 (+), U1.8 (VDD)
unnamed: R1.1, U4.8 (Rs)
unnamed: U1.1 (OSCI), Y1.1
unnamed: U1.2 (OSCO), Y1.2
SCL_2: U1.6 (SCL)
SDA_2: U1.5 (SDA)
~CS: U3.1 (~CS)
