mrrb/tfg/docs/proyecto/memoria/fig/diagramas_FPGA/diagramas_funcionamiento/diagramas_funcionamiento.kicad_pcb

## KiCad design Module_2.sch

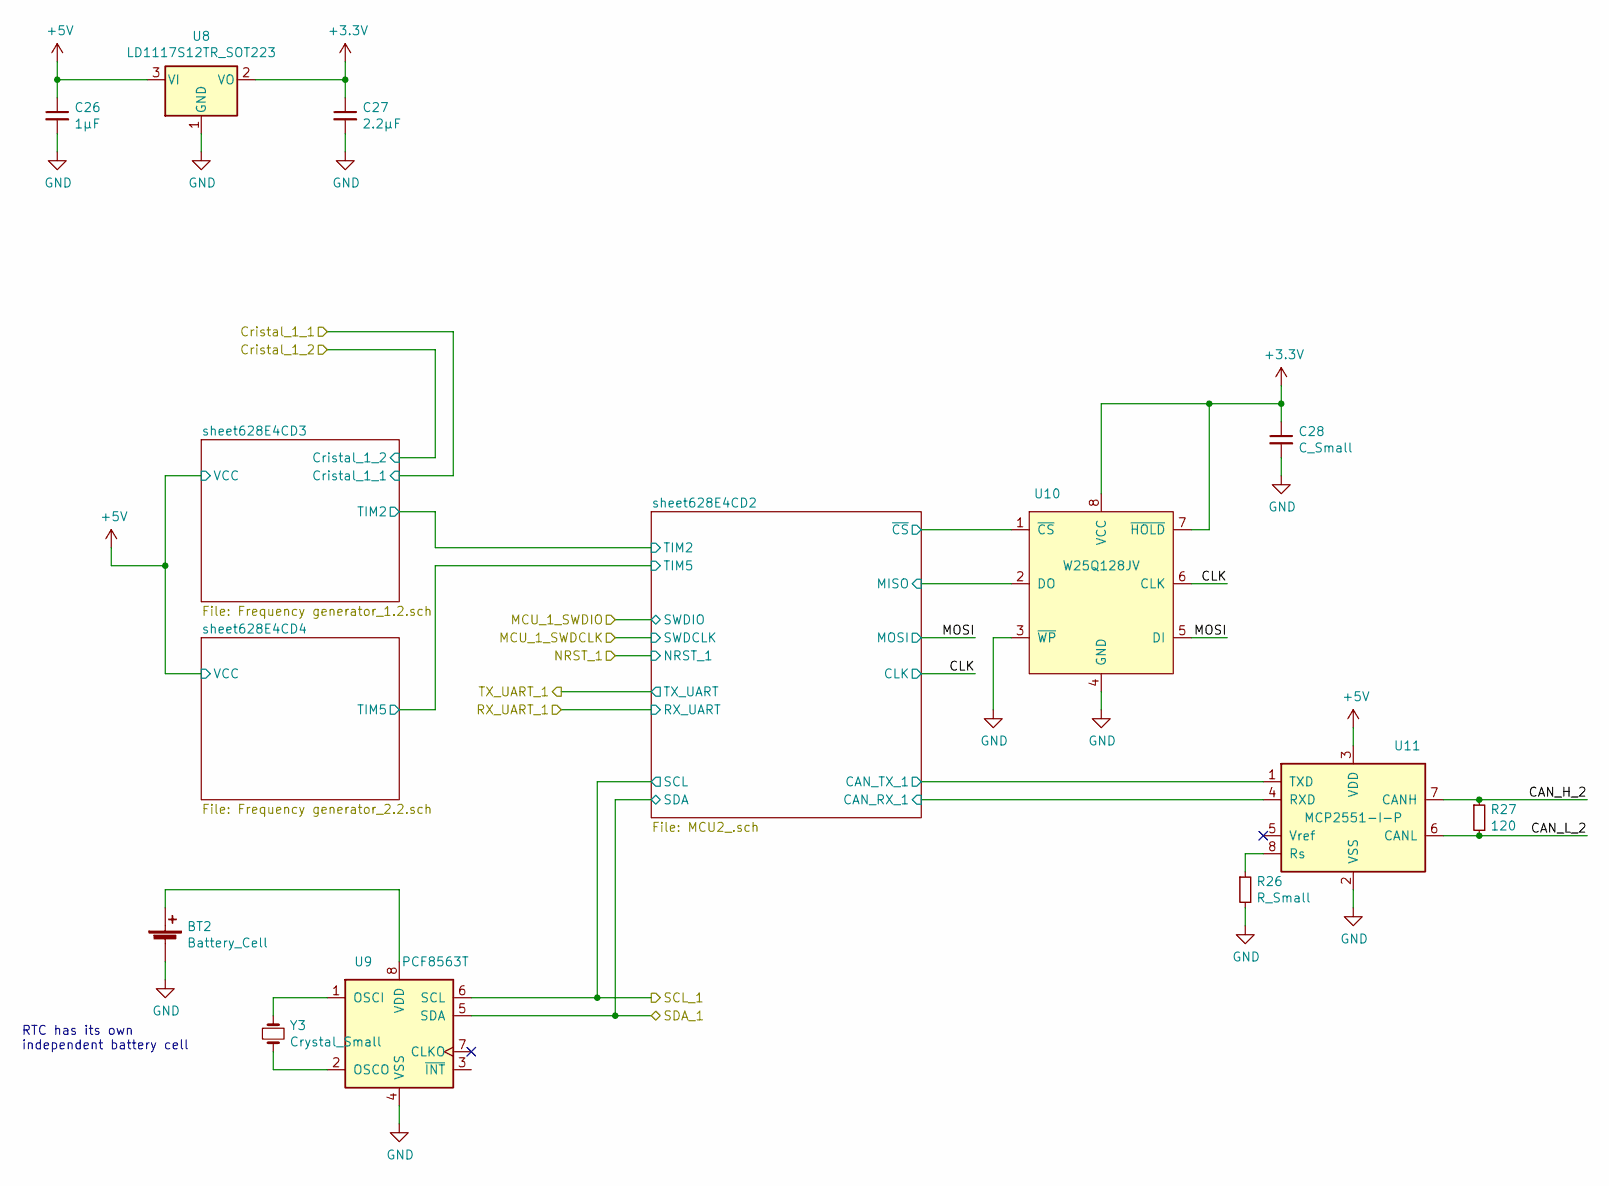
[picture p66: schematic Module_2.sch]

Parts:
BT2: Battery_Cell
C26: 1µF
C27: 2.2µF
C28: C_Small
R26: R_Small
R27: 120
U8: LD1117S12TR_SOT223; SOT-223-3_TabPin2
U9: PCF8563T; SOIC-8_3.9x4.9mm_P1.27mm
U10: W25Q128JV
U11: MCP2551-I-P; DIP-8_W7.62mm
Y3: Crystal_Small

Connections:
+3.3V: C27.1, C28.1, U8.2 (VO), U10.7 (~HOLD), U10.8 (VCC)
+5V: C26.1, U8.3 (VI), U11.3 (VDD)
CAN_H_2: R27.1, U11.7 (CANH)
CAN_L_2: R27.2, U11.6 (CANL)
CAN_RX_1: U11.4 (RXD)
CAN_TX_1: U11.1 (TXD)
CLK: U10.6 (CLK)
GND: BT2.2 (-), C26.2, C27.2, C28.2, R26.2, U8.1 (GND), U9.4 (VSS), U10.3 (~WP), U10.4 (GND), U11.2 (VSS)
MISO: U10.2 (DO)
MOSI: U10.5 (DI)
unnamed: BT2.1 (+), U9.8 (VDD)
unnamed: R26.1, U11.8 (Rs)
unnamed: U9.1 (OSCI), Y3.1
unnamed: U9.2 (OSCO), Y3.2
SCL_1: U9.6 (SCL)
SDA_1: U9.5 (SDA)
~CS: U10.1 (~CS)

Notes on the sheet:
RTC has its own independent battery cell
