mrrb/tfg/PC/app/src/thread_functions.h

#ifndef _THREAD_FUNCTIONS_H_
#define _THREAD_FUNCTIONS_H_

/* App serial thread loop */
void *serial_thread_loop(void *vargp);

/* App serial thread loop */
void *menu_thread_loop(void *vargp);

#endif /* _THREAD_FUNCTIONS_H_ */
