mrrb/tfg/ICEstick/USB3300_sniffer/modules_simulation/SB_PLL40_CORE/rtl/SB_PLL40_CORE.v

module SB_PLL40_CORE #(
                       parameter FEEDBACK_PATH = "SIMPLE",
                       parameter DIVR = 4'b0000,
                       parameter DIVF = 7'b1000010,
                       parameter DIVQ = 3'b011,
                       parameter FILTER_RANGE = 3'b001
                      )
                      (
                       input  wire RESETB,
                       input  wire BYPASS,
                       input  wire REFERENCECLK,
                       output wire LOCK,
                       output wire PLLOUTCORE
                      );

    assign LOCK = RESETB ? 1'b1 : 1'b0;

    reg clk_pll = 1'b0;
    assign PLLOUTCORE = clk_pll;
    always #0.06 clk_pll = ~clk_pll;

endmodule
