mrrb/tfg/(commit log)

2017-10-28 Modulo de memoria
2017-10-28 Actualizacion de memoria
2018-03-28 Pequeños cambios para funcionar con el codigo viejo
2018-03-29 Added interrupt base USb3300 controller
2018-04-12 Borrado de archivos temporales
2018-04-21 Pruebas de captura ULPI tanto con FPGA como con micro
2018-05-21 UART Working!
2018-05-26 USB3300 parser WIP & UART module tweak
2018-05-27 USB3300 parser done, but not working :(
    [UART.v, USB3300_parser.v, fifo_stack.v]
2018-07-16 ULPI (REGs write and read only) done with some bugs that must be solved
    [ULPI.v, ULPI_tb.v]
2018-07-18 Fixed some errors in the mux and ULPI modules
    [ULPI.v, ULPI_REG_READ.v, ULPI_REG_READ_tb.v, ULPI_REG_WRITE.v]
2018-09-05 New ref docs
    [iCE40PinoutHX1K.xlsx]
2018-09-22 SPI obsolete in favor of FT2232H synchronous FIFO & other minor changes
2018-09-23 Added IceStick manual (w/ schematic)
2018-09-24 New SPI module
2018-09-24 Added figured reference to SPI state machine
2018-09-27 WIP: SPI communication module (custom frame)
2018-09-28 WIP [2]: Fixed some SPI errors
    [top.v]
2018-10-02 Add Flow diagrams
2018-10-04 SPI fixes
2018-10-04 Add SPI GTKwave file
2018-10-05 Update top.v w/ SPI controller and some general registers
2018-10-05 Update UART Makefile for new Verilog Headers
2018-10-06 Fix and tweaks. Update style and comments of some modules.
    [UART.v, UART_tb.v]
2018-10-15 Add simple SPI transmission
2018-10-15 Add FTDI (SPI/MPSSE) reference documents
2018-10-18 Final [dirty] version(?) of the SPI controller
2018-10-31 Add final UART module
2018-10-31 Move old project
    [Internal_notes.ods]
2018-11-07 Add FIFO_BRAM_ASYNC (Not Working!!! [WIP])
    [FIFO_BRAM_ASYNC.v, FIFO_BRAM_ASYNC_tb.v]
2018-11-11 Sort Reference docs
    [iCE40PinoutHX1K.xlsx]
2018-11-13 Switch PNR from arachne to nextpnr; Add option to plot project
2018-11-19 Fix BRAM initialization in FIFO BRAM SYNC module
    [FIFO_BRAM_SYNC_.v]
2018-11-19 Add internal FIFO buffer to the Tx UART module
2018-11-19 Add buffer to UART Rx module
2018-11-19 Working UART test
2018-11-19 Add setting to select SYNC or ASYNC RESET
    [FIFO_REG.v, clk_baud_pulse.v, clk_div.v, shift_register.v]
2018-11-21 Fix UART Synchronous/Asynchronous text
    [UART_Rx.v, UART_Tx.v]
2018-11-25 Fix timing & Add edge data selecction
    [ULPI_REG_READ.v, ULPI_REG_READ_tb.v, ULPI_REG_WRITE.v, ULPI_REG_WRITE_tb.v]
2018-11-26 Add 3D base for the IceStick and USB3300
    [P1_V1.stl, test.stl]
2019-01-29 Project to test the external buttons
2019-02-01 Fix main controller UART
    [main_controller.v]
2019-02-05 Add new status to force sent a UART byte
2019-02-05 Added USB connector drawings
2019-02-05 Añadidos esquemas de captura
2019-02-22 Add multiple threads to control the menu & serial
2019-02-22 Add FPGA working diagrams
    [UART.sch, UART_Rx.sch, UART_Tx.sch, diagramas_funcionamiento.kicad_pcb, diagramas_funcionamiento.sch]
2019-02-25 Esquemas FPGA
    [ULPI.sch, ULPI_RECV.sch, ULPI_REG_READ.sch, ULPI_REG_WRITE.sch, ULPI_op_stack.sch, diagramas_funcionamiento.sch, main_controller.sch, shift_register.sch]
2019-02-26 Pequeños retoques en las máquinas de estados
2019-06-02 Fix some writting erros
    [ULPI_REG_WRITE.v]
2019-06-02 Add connectors SVGs
2019-06-02 Add some internal diagrams
    [diagramas_funcionamiento.sch]
2019-06-07 Añadidos flujos funcionamiento de varios módulos
2019-06-07 New flowdiagram's item
2019-06-08 Añadida bibliografía de la plantilla
2019-06-09 Actulización de bibliografía
2019-06-09 Diagrama de flujo main_controller [WIP]
2019-06-09 Actualización de objetivos
2019-06-11 División de los resultados en dos grupos
2019-06-13 Revisión de los resultados HW
2019-06-13 Revisión de los resultados SW
2019-06-13 Revisión de las figuras de simulación
2019-06-13 Solucionado posicionamiento de figuras
